Natchpai/proDigialClockE31/Picture1.png

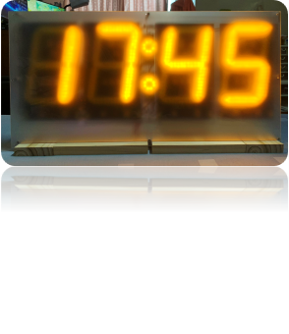
Picture1.png
