Natchpai/proDigialClockE31/Diagrams/Power and control.png

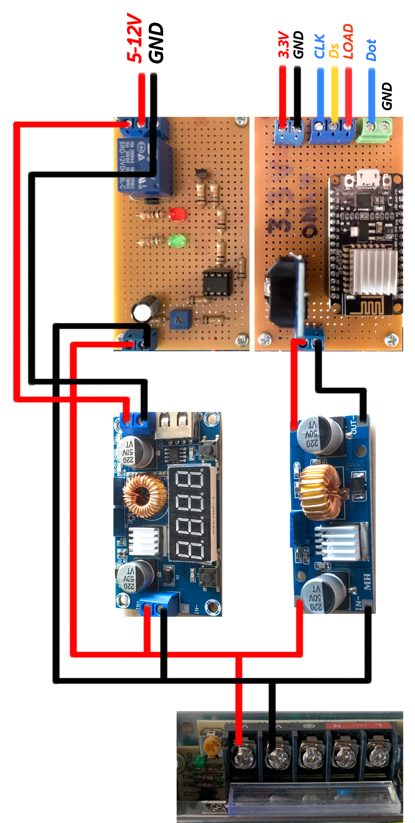
Diagrams/Power and control.png
