Natchpai/proDigialClockE31/README.md

# 4-Digit Digital Clock Class Project
A 4-Digit Digital Clock controlled by ESP8266, Uses custon 7-segment Displays. <br/>
The clock connects to WiFi Automatically to Calibrate its time.



## Features
- Automatic time calibrate via NTP (Network time Protocal)
- Automatic WiFi reconnection
- Room temperature measurement
  
- Size WxH: 60x30cm.
## Last Updated
- **Update 2025: it's working in my room.**
