Natchpai/proDigialClockE31/digitalClockV5.pdf

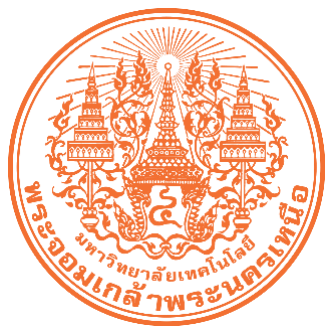
[picture p3: figure]

## รายงาน เรื่อง นาฬิกาดิจิตอล

## จัดทำโดย

## นางสาวกฤติมา พัฒน์ซ้าย

นายธนัท | ตันอึ๊ง
นายณัฐชนน | เถื่อนถ้ำ

## ห้อง E31

## เสนอ

## อาจารย์ปถวีร์ อดิศัยศักดา

## รายงานนี้เป็นส่วนหนึ่งของวิชา Microprocessor Practice ภาคเรียนที่ 2 ปีการศึกษา 2565 โรงเรียนเตรียมวิศวกรรมศาสตร์ ไทย-เยอรมัน

ก

### คำนำ

รายงานฉบับนี้ เป็นส่วนหนึ่งของชิ้นงานในวิชา Microprocessor Practice การจัดทำรายงานและ ชิ้นงานนี้ขึ้นมา มีวัตถุประสงค์เพื่อพัฒนาและต่อยอดนาฬิกาดิจิตอลรุ่นก่อนให้มีประสิทธิภาพมากขึ้น ด้วยรุ่น ก่อนมีปัญหาในเรื่องโครงสร้างการออกแบบที่ซับซ้อน การใช้ไมโครคอนโทรลเลอร์เกินความจำเป็น ความสว่าง ไม่เพียงพอและการสูญเสียพลังงานออกไปในรูปแบบความร้อน โดยรุ่นใหม่นี้ได้ทำการเปลี่ยนโครงสร้างใหม่ ทั้งหมด ซึ่งสามารถปรับระดับความสว่างได้ทำให้การสูญเสียน้อยลง เปลี่ยนวิธีการแสดงผลโดยการใช้ไอซี เลื่อนบิตหรือรีจิสเตอร์แทนที่การแสดงผลด้วยการกระพริบของตัวเลขอย่างรวดเร็ว

แต่รุ่นใหม่นี้ก็ยังมีปัญหาที่เกิดขึ้นอยู่นั้นก็คือ โมดูลนาฬิกา หรือ Real Time Clock Module ในบาง เวลาที่เปิดใช้งานใหม่ๆ ตัว NodeMCU เองไม่สามารถอ่านค่าจากตัวโมดูลนาฬิกาได้จึงจำเป็นต้องถอดตัวโมดูล นาฬิกาออกและใส่เข้าไปใหม่ก็จะใช้งานได้ตามปกติ อันที่จริงแล้วปัญหาที่เกิดขึ้นระหว่างทำชิ้นงานนั้นมีมากเหลือล้น ยกตัวอย่างเช่นการเลือกอุปกรณ์ อย่างทรานซิสเตอร์จะทำอย่างไรให้เกิดความร้อนน้อยที่สุด แต่อย่างไรก็ตามสุดท้ายแล้วก็สามารถทำมันให้ สำเร็จจนได้การจัดทำรายงานและนาฬิกาเรือนนี้ขึ้นมานั้น ผู้พัฒนาหวังว่าจะเป็นประโยชน์ให้กับผู้ที่สนใจ และ ขอขอบคุณที่สละเวลาอันมีค่าของท่านที่อ่านมาถึงตรงนี้ ขอบคุณครับ

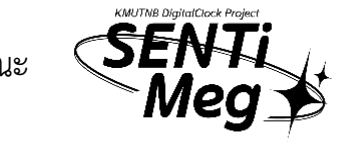
[picture p4: figure]

นายณัฐชนน เถื่อนถ้ำ และคณะ

ข

### สารบัญ

เรื่อง | หน้า
คำนำ | ก
สารบัญ | ข

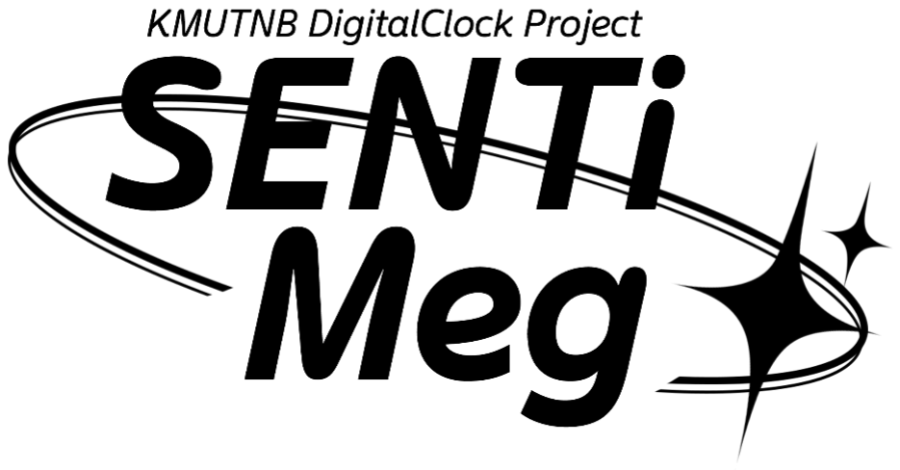
[picture p5: figure]

### ที่มาและความสำคัญ

นาฬิกาดิจิตอลเรือนนี้ได้พัฒนาและต่อยอดมาจากรุ่นก่อนที่มีปัญหาหลายด้าน ด้วยรุ่นก่อนที่มีการ ออกแบบที่ซับซ้อน เสริมนี่นิดเติมนี่หน่อยจนพันกันมั่วไปหมด อีกทั้งปัญหาจากความร้อนที่เกิดขึ้นทำให้เกิด การสูญเสียพลังงานไฟฟ้าโดยไม่ให้เกิดประโยชน์และได้รับหัวข้อมานั้นก็คือการรวมเอาไมโครคอนโทรลเลอร์ สองตัวมารวมกันให้เป็นหนึ่ง โดยรุ่นก่อนจะให้ตัว NodeMCU เป็นตัวดึงข้อมูลเวลาจากอินเตอร์เน็ตแล้วส่งให้ ตัว Arduino กับโมดูลนาฬิกาแสดงผลออกไปที่ 7-Segments ผ่านระบบการกระพริบทีละหลักอย่างรวดเร็ว โดยรุ่นใหม่ที่ได้พัฒนามานี้ได้ทำการเปลี่ยนโครงสร้างใหม่ทั้งหมด โดยเปลี่ยนวิธีการแสดงผล โดยการใช้ไอซี เลื่อนบิตหรือรีจิสเตอร์แทน ซึ่งทำให้มีสายสัญญาณที่น้อยกว่ามาก ลดภาระของตัวไมโครคอนโทรลเลอร์

### คุณสมบัติและสรรพคุณ

นาฬิกาตั้งโต๊ะหรือนาฬิกาแขวนผนัง (ยกเว้น Smart Watch) นั้นมีปัญหาคือต้องตั้งเวลาด้วยตัวเอง หรือก็คือระบบ Manual ซึ่งอาจจะทำให้เวลาคลาดเลื่อนได้จากความเป็นจริงหรืออาจจะเกียจคร้านในการตั้ง พวกเราจึงได้พัฒนาต่อยอดนาฬิกาให้สามารถตั้งเวลาอัตโนมัติเมื่อมีอินเตอร์เน็ตที่สามารถเชื่อมต่อได้สามารถ เชื่อมต่ออินเตอร์เน็ตใหม่ได้เมื่อสัญญาณขาดหายไปชั่วขณะ สามารถปรับความสว่างได้ สามารถตัดระบบเมื่อ แรงดันไฟเกินกำหนดซึ่งเกิดจากการปรับความสว่างที่มากเกิน สามารถแสดงอุณหภูมิห้องได้

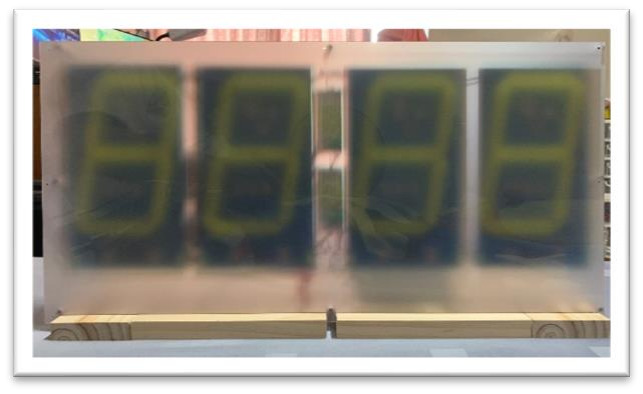
[picture p6: figure]
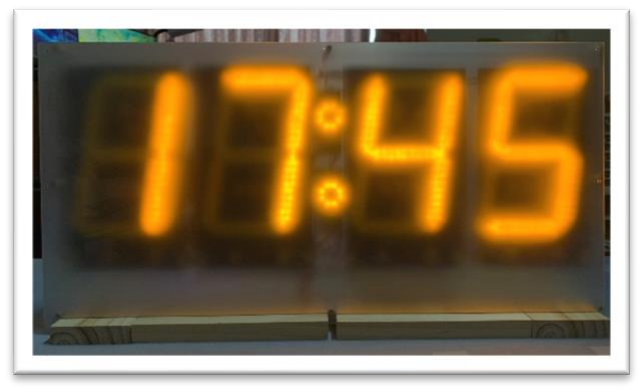
[picture p7: figure]
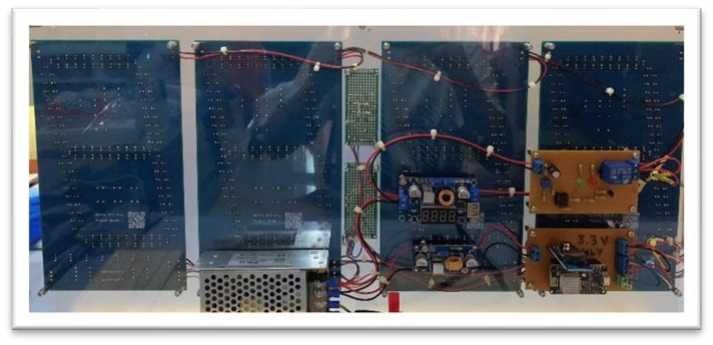
[picture p8: figure]

### วิธีการใช้งาน

### 1. การใช้งาน Buck Converter

Buck Converter หรือ Step down เป็นวงจรอิเล็กทรอนิกส์ที่สามารถทำแรงดันไฟตรงให้ที่เข้ามา ลดลงได้เพื่อให้ค่าแรงดันไฟฟ้ามีความเหมาะสมสำหรับการนำไปใช้ในงานอื่นๆ โดยที่นาฬิกาดิจิตอลเรือน นี้ได้นำวงจรนี้มาใช้ด้วยกัน 2 ตัวคือ
1. Buck Converter (Main)
2. Buck Converter (Sub)
1.1Buck Converter (Main)

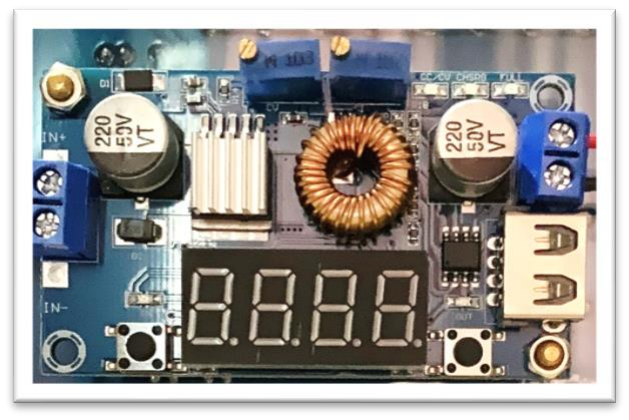
[picture p9: figure]

### 1.1.1 การปรับและควบคุมแรงดันไฟฟ้ากระแสตรง

วงจร Step down วงจรนี้ทำหน้าที่จ่ายกำลังหลักให้กับหน้าจอแสดงผลโดย สามารถปรับแรงดันได้โดยการปรับทริมพอร์ตด้านซ้ายมือสุด โดยจะมีสัญลักษณ์ CV หรือ (Control Voltage) กำกับที่ตัวทริมพอร์ต ส่วนทริมพอร์ตด้านขวาสุดจะเป็นการปรับ กระแสสูงสุด โดยจะมีสัญลักษณ์ CC หรือ (Control Current) กำกับที่ตัวทริมพอร์ตอยู่

### 1.1.2 การตั้งค่าหน้าจอแสดงผล

วงจร Step down วงจรนี้มีหน้าจอแสดงผลอยู่และมีปุ่มข้างซ้ายและขวาของ จอแสดงผล ปุ่มซ้ายเป็นการปิดหน้าจอแสดงผล ส่วนปุ่มขวาจะเป็นการเลือกโหมด การแสดงผลโดยจะมีอยู่ 4 โหมดดังนี้คือ 1. แรงดันอินพุต 2. แรงดันเอาต์พุต 3. กระแสเอาต์พุต 4. กำลังเอาต์พุต หรือจะดูที่สัญลักษณ์ V (Volt) A (Amp) และ P (Power) ก็ได้ โดยจะมีไฟแสดงสถานะเป็นสีแดงด้านบนปุ่มกดทั้งสอง ถ้าสว่าง ทางด้านปุ่มซ้ายมือหมายถึงแสดงผลทางด้านอินพุต ถ้าสว่างทางขวามือหมายถึง แสดงผลทางเอาต์พุต

### วิธีการใช้งาน (ต่อ)

### 1.2 Buck Converter (Sub)

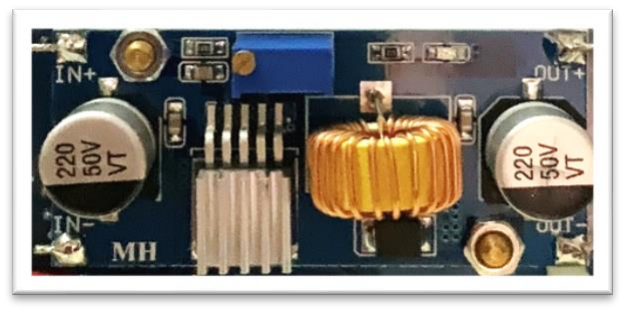
[picture p10: figure]

### 1.2.1 การปรับและควบคุมแรงดันไฟฟ้ากระแสตรง

วงจร Step down วงจรนี้ทำหน้าที่จ่ายกำลังให้กับตัวไมโครคอนโทรลเลอร์และ ไอซีควบคุมต่างๆในซึ่งเป็นส่วนหนึ่งของวงจรแสดงผลโดยสามารถปรับแรงดันได้โดยการ ปรับทริมพอร์ตสีน้ำเงินตรงกลาง โดยจะไม่แนะนำให้ทำการปรับแรงดันไฟฟ้าในวงจรนี้ เพราะตัวไมโครคอนโทรลเลอร์เองอาจได้รับความเสียหายได้โดยวงจรนี้จะทำการคงที่ แรงดันไว้ประมาณ 3.28 Volt

### 2. การเชื่อมต่อกับอินเตอร์เน็ต

กระจายไวไฟผ่านมือถือหรือจะเป็นเร้าเตอร์ที่สามารถเข้าถึงอินเตอร์เน็ตได้ ตัว NodeMCU สามารถ เชื่อมต่อสัญญาณใหม่ได้ตลอดเวลาโดยไม่ต้องกดปุ่มใดๆ แต่จำเป็นต้องตั้งค่าชื่อและรหัสผ่านของไวไฟที่ ต้องการให้เชื่อมต่อด้วย (จะกล่าวถึงในส่วนถัดๆไป)

### 3. การปรับความสว่างการแสดงผล

การปรับความสว่างการแสดงผลสามารถปรับได้โดยการเพิ่มหรือลดแรงดันไฟตรงที่จ่ายให้กับหน้าจอ แสดงผลหลัก โดยการปรับทริมพอร์ตด้านซ้ายมือสุดที่วงจร Buck Converter (Main) โดยจะมีสัญลักษณ์ CV หรือ (Control Voltage) กำกับที่ตัวทริมพอร์ตเอง (สามารถดูเพิ่มเติมได้จากหน้าที่ 2 หัวข้อการปรับ และควบคุมแรงดันไฟฟ้ากระแสตรง)

### 3.1 การกำหนดความสว่างสูงสุดให้กับหน้าจอแสดงผล

การกำหนดความสว่างหรือแรงดันสูงสุดให้กับหน้าจอแสดงผลเพื่อป้องกันการเกิดอัคคีภัยที่ อาจเกิดขึ้นได้จากความร้อนได้ที่ตัววงจรสร้างขึ้นเพราะมีแรงดันอินพุตที่สูงเกินไปจากการปรับ ความสว่างหน้าจอของตัวคุณเอง (วิธีการตั้งค่าอยู่หน้าถัดไป)

### วิธีการใช้งาน (ต่อ)

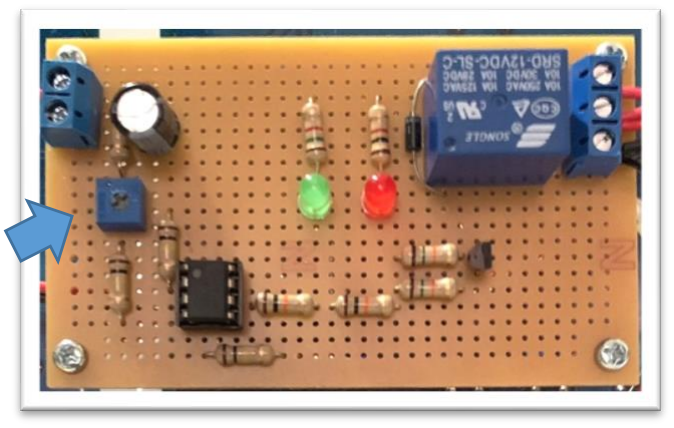
[picture p11: figure]

วิธีการตั้งค่าแรงดันสูงสุดมี 3 ขั้นตอน คือ

1. ปรับแรงดันสูงสุดตามที่ต้องการที่ตัว Buck Converter (Main) โดยดูทางด้านแรงดันเอาต์พุต
2. ปรับทริมพอร์ตสีน้ำเงินทางซ้ายมือที่อยู่ในบอร์ดในภาพด้านบนจนกว่าไฟสถานะสีแดงจะสว่างขึ้น หรือถ้าสว่างอยู่แล้วให้ปรับจนกว่าจะไฟจะดับลงแล้วค่อยๆปรับขึ้นใหม่จนไฟสถานะติดอีกครั้ง
3. ลดแรงดันเอาต์พุตที่ตัว Buck Converter (Main) ที่ตั้งไว้ตอนแรก ให้อยู่ในสถานะปกติ เมื่อวงจรอยู่ในสถานะปกติจะมีไฟสถานะสีเขียวติดอยู่แสดงว่าวงจรสามารถทำงานได้ส่วนไฟสถานะสี แดงหมายถึงการตัดการจ่ายไฟหลักให้กับวงจรแสดงผล

### 4. การตั้งค่าการเชื่อมต่ออินเตอร์เน็ตและอื่นๆ

การตั้งค่าการเชื่อมต่ออินเตอร์เน็ตหรือการเปลี่ยนชื่อและรหัสไวไฟหรือการตั้งค่าต่างๆนั้นจำเป็นอย่าง มากที่จะต้องอัปโหลดโปรแกรมใหม่ให้กับตัวไมโครคอนโทรลเลอร์มีวิธีดังนี้
1. สแกน QR CODE ด้านหลังแผงวงจร หรือเข้าลิงก์ https://github.com/Natchpai/proDigialClockE31 (ไม่ใช่ proDigitalClockE31)
2. ไปที่โฟลเดอร์ชื่อ CODE / FINAL_CODE_ClockProject ตามรูปด้านล่าง (แต่ถ้าสแกน QR CODE ให้ไปที่โฟลเดอร์ชื่อ DigitalClockProject ก่อน)

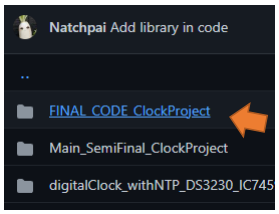
[picture p12: figure]
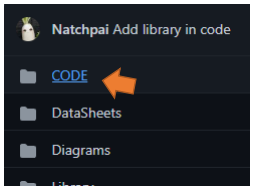
[picture p13: figure]

### วิธีการใช้งาน (ต่อ)

3. FINAL_CODE_ClockProject.ion เป็นโค้ดที่จำเป็นต้องลง Library บางตัว สามารถดู เพิ่มเติมได้ในโค้ด ส่วนในโฟลเดอร์นี้จะมีมาให้ 2 ตัว สามารถลงได้เลย

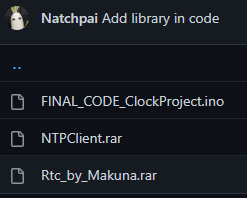
[picture p14: figure]

4. สามารถเปลี่ยน SSID และ password แล้วอัปโหลดใหม่ได้เลย ส่วน pullData_hour คือการตั้งเวลาทุกๆกี่ชั่วโมง เมื่อมีการเชื่อมต่ออินเตอร์เน็ต ในที่นี้คือ ทุกๆ 6 ชม.

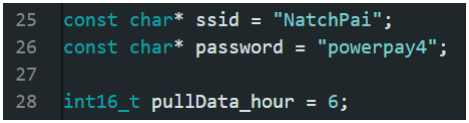
[picture p15: figure]

5. สามารถเปลี่ยนเวลาการเปลี่ยนโหมดระหว่างแสดงเวลากับอุณหภูมิได้ ในเงื่อนไข mode == 1 คือแสดงเวลา ส่วน mode == 2 คือแสดงอุณหภูมิ

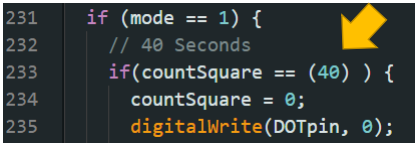
[picture p16: figure]
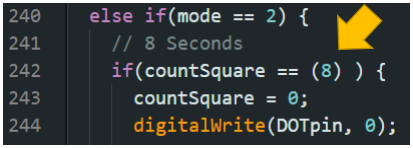
[picture p17: figure]

### ข้อควรระวัง

1. ไม่แนะนำให้ปรับแรงดันที่วงจร Buck Converter (Sub) เพราะอาจจะทำให้ไมโครคอนโทรลเลอร์ เสียหายได้ ซึ่งวงจรนี้จะคงแรงดันไว้ที่ 3.28 Volt โดยประมาณ
2. ไม่แนะนำให้ปรับ CC หรือ Control Current ที่วงจร Buck Converter (Main)
3. ไม่แนะนำให้ตั้ง CC หรือ CV ที่วงจร Buck Converter (Main) ผ่านการกดปุ่ม
4. อย่าปรับความสว่างหรือแรงดันมากจนเกินเพราะอาจเกิดอัคคีภัยได้
5. ระวังแผ่นอะคริลิกแตก

### ปัญหาที่อาจเกิดขึ้นได้

ปัญหาโมดูลนาฬิกา หรือ Real Time Clock Module ในบางเวลาที่เปิดใช้งานใหม่ๆ ตัว NodeMCU เองไม่สามารถอ่านค่าจากตัวโมดูลนาฬิกาได้ทำให้เกิดการแสดงเวลาที่ผิดเป็นเวลา 00:00 และ 00°C มีวิธีแก้ด้วยกัน 2 วิธีคือ

1. ถอดปลั๊กนาฬิกาออกจากเต้าแล้วเสียบเข้าไปใหม่อีกทีหรือ
2. ดึงโมดูลนาฬิกาออกและใส่เข้าไปใหม่ขณะที่นาฬิกากำลังทำงานอยู่ (ใส่ให้ถูกด้านด้วย)

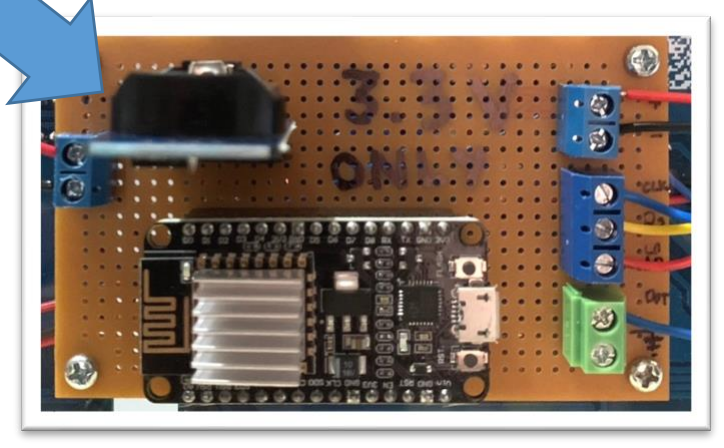
[picture p18: figure]

### ส่วนประกอบของชิ้นงาน

### 1. โดยภาพรวม

1. หน้าจอแสดงผล 7-Segments x 4 แผ่น | 5. Buck Converter ขนาด 2 แอมป์

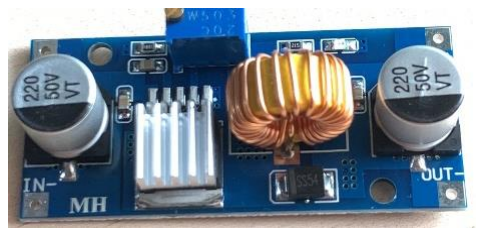
[picture p19: figure]

6. NodeMCU ESP8266 V2

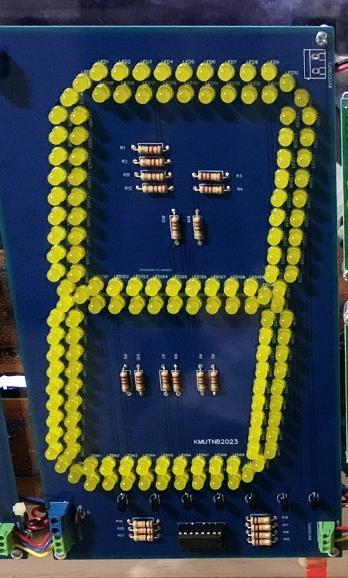
[picture p20: figure]
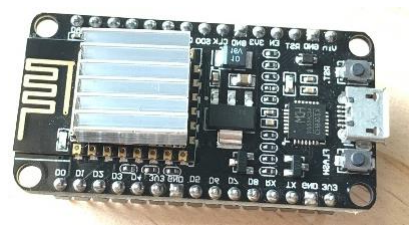
[picture p21: figure]
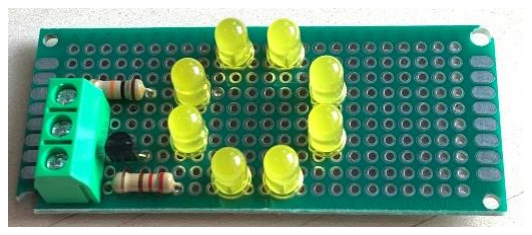
[picture p22: figure]
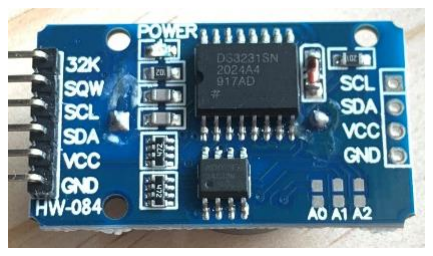
[picture p23: figure]

2. หน้าจอแสดงผลแบบ Dot x 2 แผ่น | 7. DS3231 (RTC Module)

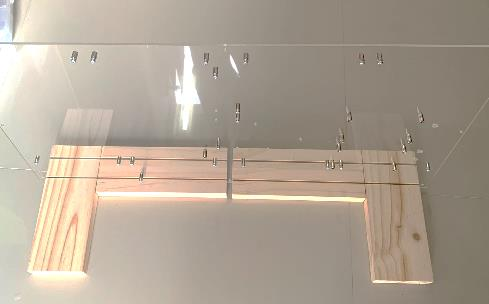
[picture p24: figure]
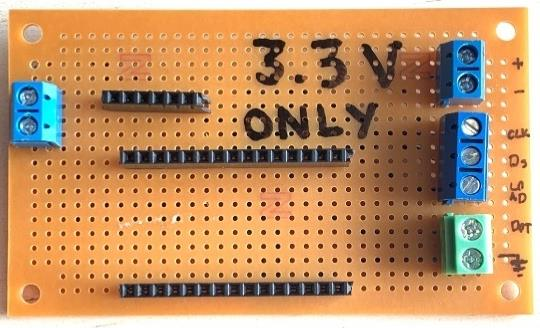
[picture p25: figure]

3. ฐานไม้ แผ่นอะคริลิกใส และแผ่นอะคริลิกขุ่น | 8. ฐานใส่ NodeMCU, RTC Module

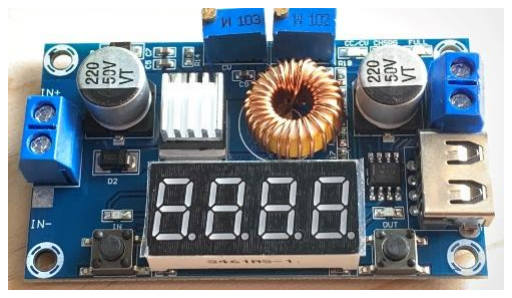
[picture p26: figure]
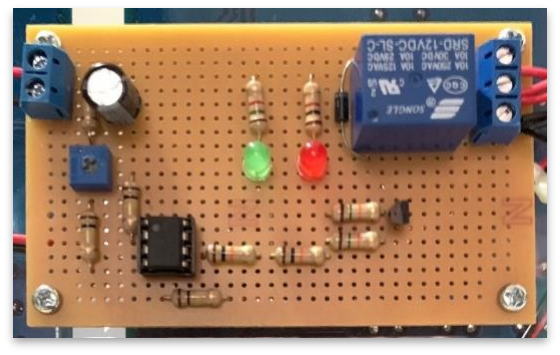
[picture p27: figure]

4. Buck Converter ขนาด 5 แอมป์ | 9. วงจรตัดแรงดันไฟเกินกำหนด

### ส่วนประกอบของชิ้นงาน (ต่อ)

10. Power Supply ขนาด 220VAC แปลงเป็น 12VDC-5A.

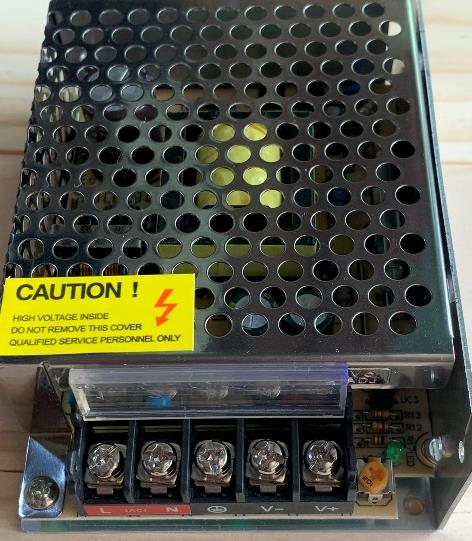
[picture p28: figure]

ภาพรวมด้านหน้า

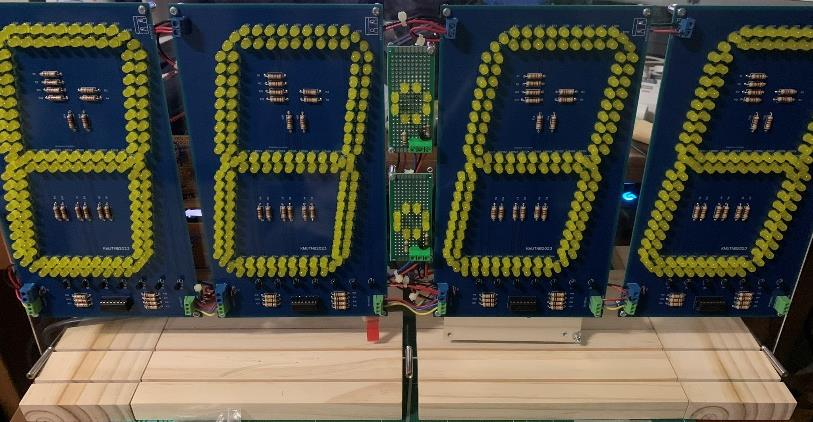
[picture p29: figure]

ภาพรวมด้านหลัง

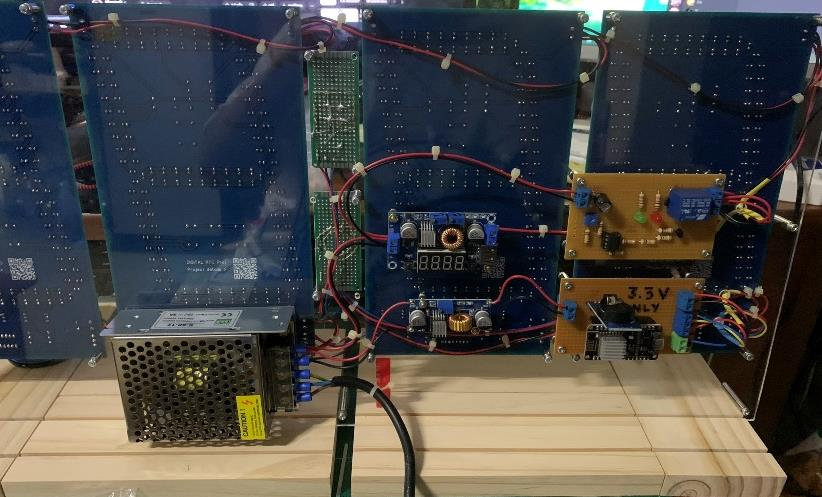
[picture p30: figure]

### ส่วนประกอบของชิ้นงาน (ต่อ)

### 2. อุปกรณ์ในหน้าจอแสดงผล 7-Segments

1. แผ่น PCB x 1 แผ่น
2. หลอด LED สีเหลืองขนาด 5mm. x 140 ดวง
3. ตัวต้านทาน 220 Ω x 14 ตัว
4. ตัวต้านทานขนาด 10 KΩ x 7 ตัว
5. ทรานซิสเตอร์เบอร์ 2N3904 x 7 ตัว
6. ไอซีเบอร์ 74HC595 พร้อม Socket 16 pin x 1 ตัว
7. ตัวเก็บประจุชนิดเซรามิก 0.1µF x 1 ตัว
8. Screw Terminal ขนาด 5mm. 2 pin x 2 ตัว
9. Screw Terminal ขนาด 3.5mm. 3 pin x 2 ตัว

### 3. อุปกรณ์ในวงจรตัดแรงดันไฟเกินกำหนด

1. รีเลย์ไฟตรงขนาด 12 โวลต์ เบอร์ SRD-12VDC-SL-C x 1 ตัว
2. ไดโอดเบอร์ 1N4001 x 1 ตัว
3. หลอด LED 5mm. สีแดงและสีเขียว อย่างละ 1 ดวง
4. ตัวต้านทานขนาด 15 KΩ x 2 ตัว
5. ตัวต้านทานขนาด 10 KΩ x 2 ตัว
6. ตัวต้านทานขนาด 100 KΩ x 4 ตัว
7. ตัวต้านทานขนาด 1 KΩ x 1 ตัว
8. ตัวต้านทานขนาด 1.5 KΩ x 1 ตัว
9. ทริมพอร์ต 1 รอบ ขนาด 50 KΩ x 1 ตัว
10. ไอซีเบอร์ LM741 พร้อม Socket 8 pin x 1 ตัว
11. ทรานซิสเตอร์เบอร์ 2N3904 x 1 ตัว
12. ตัวเก็บประจุชนิดอิเล็กโทรไลต์ขนาด 100µF 50V x 1 ตัว
13. Screw Terminal ขนาด 5mm. 2 pin x 1 ตัว
14. Screw Terminal ขนาด 5mm. 3 pin x 1 ตัว
15. แผ่นวงจรสำเร็จ IC3 x 1 แผ่น

### วงจรของชิ้นงาน

1. (Diagram) ส่วนการ Control และ Power

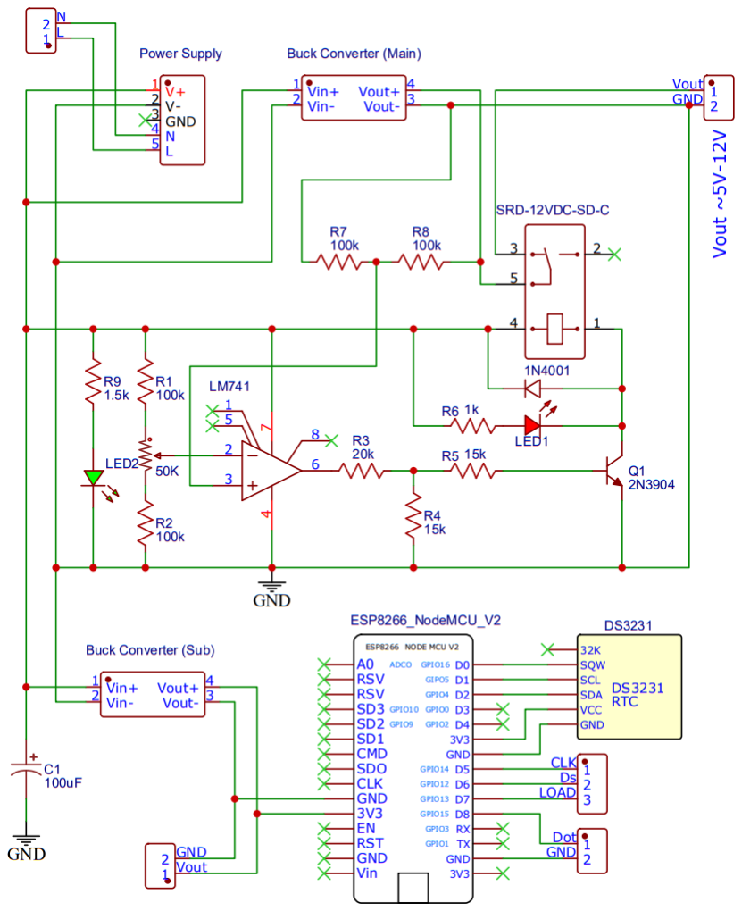
[picture p31: figure]

### วงจรของชิ้นงาน (ต่อ)

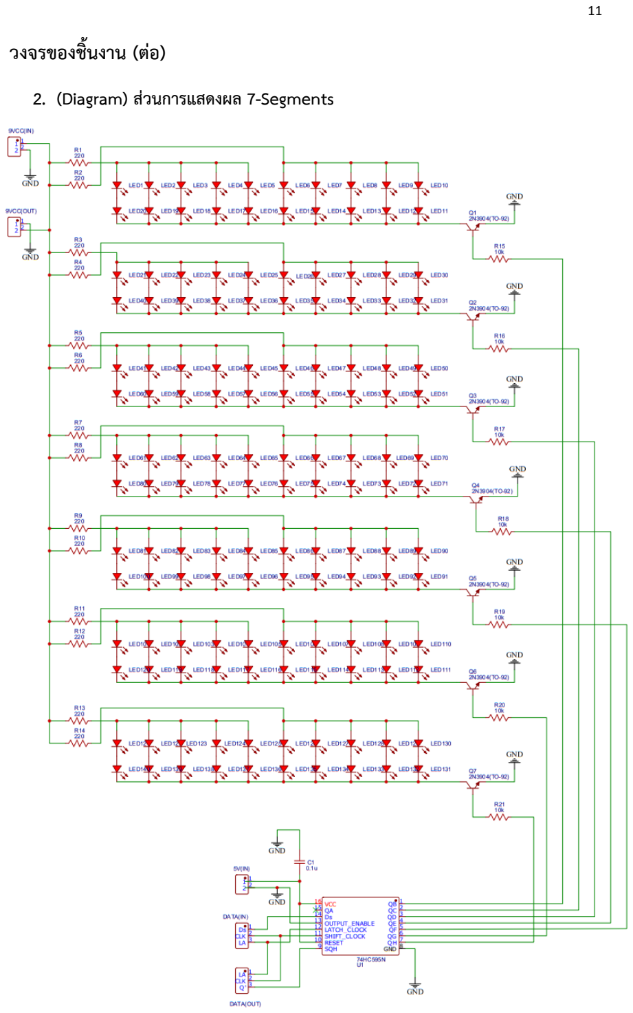
[picture p32: page 16]

2. (Diagram) ส่วนการแสดงผล 7-Segments

### วงจรของชิ้นงาน (ต่อ)

3. (การต่อจริง) ส่วนการ Control และ Power

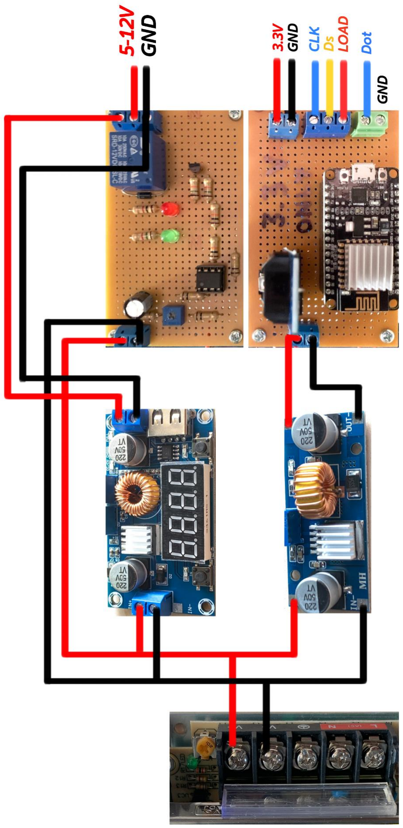
[picture p33: figure]

### วงจรของชิ้นงาน (ต่อ)

4. (การต่อจริง) ส่วนการแสดงผล 7-Segments

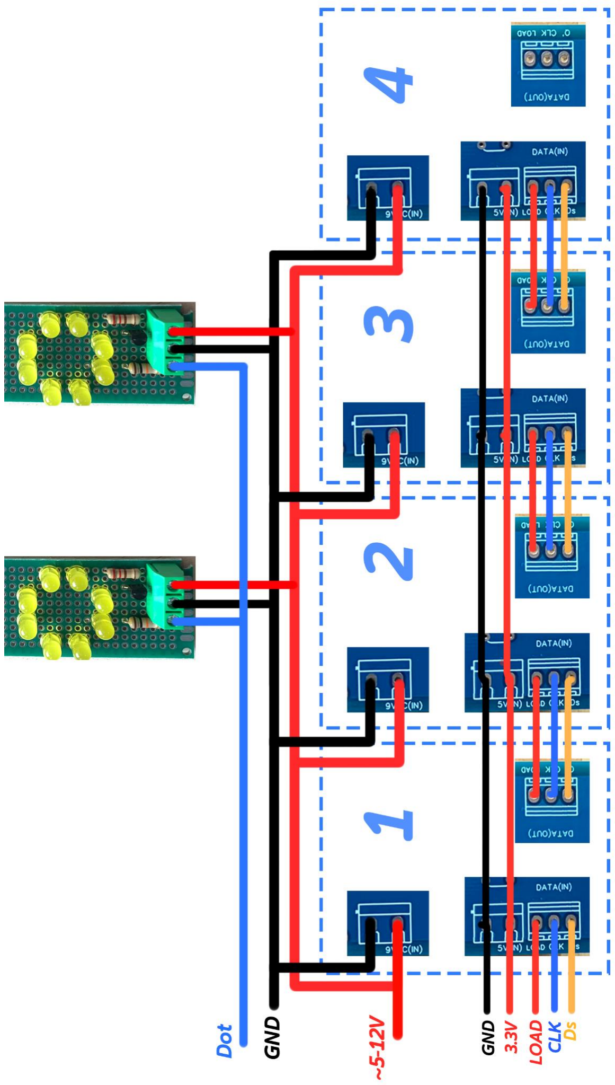
[picture p34: figure]

### เกี่ยวกับ 74HC595

ไอซี74HC595 เป็นไอซีเลื่อนบิต เมื่อมีการป้อนข้อมูลเข้าไปใหม่ บิตจะถูกเลื่อนไปตามข้อมูลที่ป้อน มี ขาทั้งหมด 16 ขา เป็นขาเอาต์พุตที่ควบคุมได้ทั้งหมด 8 ขา ตั้งแต่ Q0 Q1 Q2 ... Q7 มีขา 3 ขาสำหรับการ ควบคุมขา Q0 - Q7 ไอซีชนิดนี้จะมาช่วยในเรื่องการขยายขาส่งข้อมูลดิจิตอลให้มากขึ้น

1. ขา ST_CP หรือเทียบได้กับการ Latch เป็นขาควบคุมจังหวะการส่งข้อมูลออก เมื่อขานี้มีสถานะ เป็น HIGH จะมีการโหลดข้อมูลออกไปที่ขา Q0 Q1 Q2 ... Q7 ตามข้อมูลที่ส่งเข้ามา
2. ขา SH_CP เทียบได้กับขา Clock เป็นขาที่จะต้องป้อนสัญญาณพัลส์เข้าไปเพื่อควบคุมการรับ ข้อมูลเข้าไอซีโดยการป้อนสัญญาณจะต้องสัมพันธ์กับการป้อนข้อมูลในแต่ละบิต
3. ขา DS เป็นขาสำหรับป้อนข้อมูลเข้าไปทีละบิตตามจังหวะสัญญาณนาฬิกา
4. ขา Q7S หรือ QH’ เป็นขาข้อมูลออก สามารถนำไปต่อกับขา DS ของตัวถัดๆไปเพื่อขยาย ความสามารถในการส่งข้อมูลได้
5. ขา MR หรือขา Reset ทำงานในสถานะ LOW
6. ขา OE หรือ Output Enable Input ทำงานในสถานะ LOW

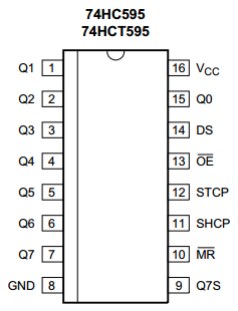
[picture p35: figure]
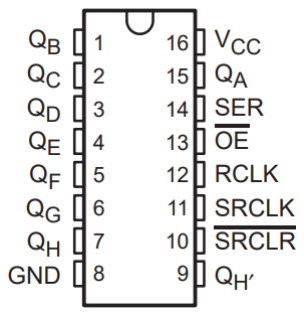
[picture p36: figure]

### เกี่ยวกับ 74HC595

การใช้งานไอซีเลื่อนบิต 74HC595 ด้วย shiftOut()
ฟังก์ชัน shiftOut เป็นฟังก์ชันส่งข้อมูลแบบซิงโครนัส โดยสามารถกำหนดขา data และ clock เข้าไปใส่ในฟังก์ชันได้โดยในที่นี้74HC595 นั้นสามารถรับข้อมูลได้มากสุด 8 บิตต่อหนึ่งตัว แต่ สามารถนำไอซีแต่ละตัวมาต่ออนุกรมกันเพื่อขยายความสามารถในการเก็บข้อมูลให้มากขึ้นได้ shiftOut(dataPin, clockPin, bitOrder, value);

dataPin คือ ขาที่ต่อใช้งานกับขา Ds ของ 74HC595
clockPin คือ ขาที่ต่อใช้งานกับขา SH_CP ของ 74HC595
bitOrder คือ การตั้งค่าการเรียงลำดับของข้อมูลที่จะส่งออกว่าจะส่งบิตความสำคัญสูงหรือ บิตความสำคัญต่ำออกก่อน MSBFIRST or LSBFIRST
value คือข้อมูลจำนวน 8 บิตที่จะส่งออก สามารถใช้ค่าจากตัวแปร byte หรือ uint8_t
1. ตัวอย่างการใช้งานฟังก์ชัน shiftOut กับ 74HC595 แบบ 8 บิต

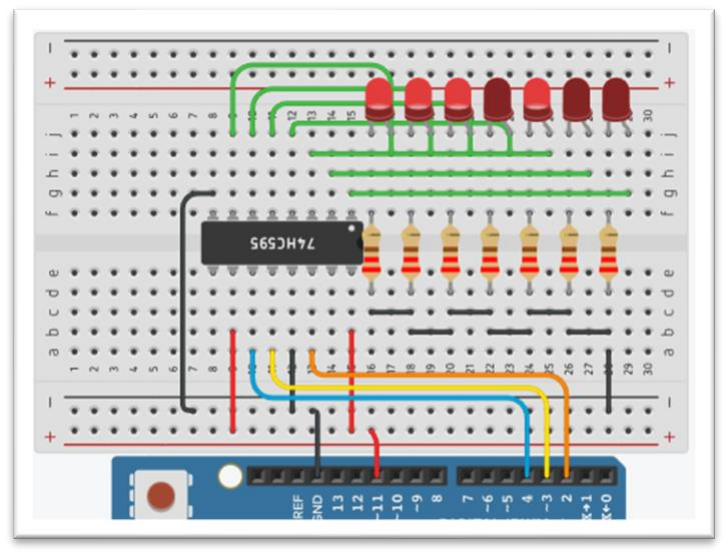
[picture p37: figure]
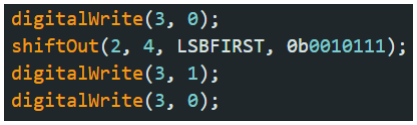
[picture p38: figure]

### เกี่ยวกับ 74HC595

การใช้งานไอซีเลื่อนบิต 74HC595 ด้วย shiftOut() (ต่อ)

2. ตัวอย่างการใช้งานฟังก์ชัน shiftOut กับ 74HC595 แบบ 16 บิต โดยการเพิ่มไอซีนั้นจำเป็นต้องนำขาที่ 9 หรือขาข้อมูลออกไปต่อกับขา 16 หรือขาข้อมูล เข้าของไอซีอีกตัว (สีเขียว) และต่อขนานสัญญาณนาฬิกา (สีฟ้า) และสัญญาณโหลดข้อมูล (สี เหลือง) ด้วยถึงจะสามารถทำงานได้

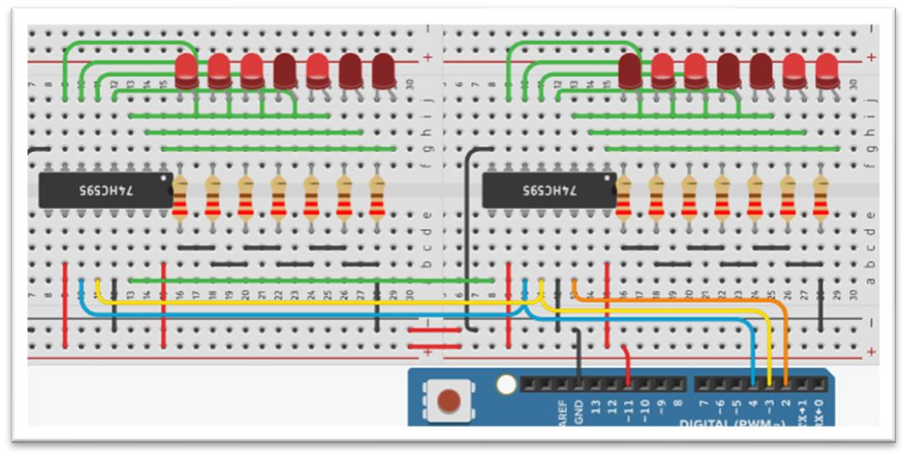
[picture p39: figure]
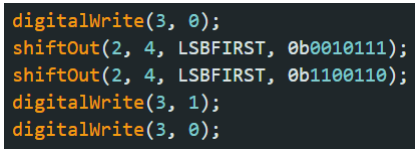
[picture p40: figure]

### โค้ดโปรแกรม

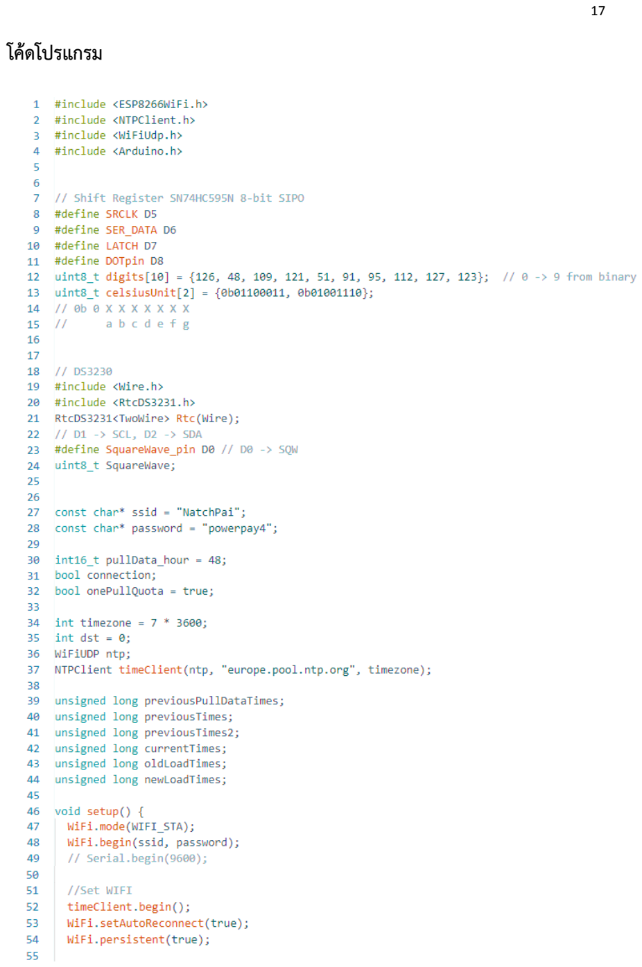
[picture p41: page 22]

### โค้ดโปรแกรม

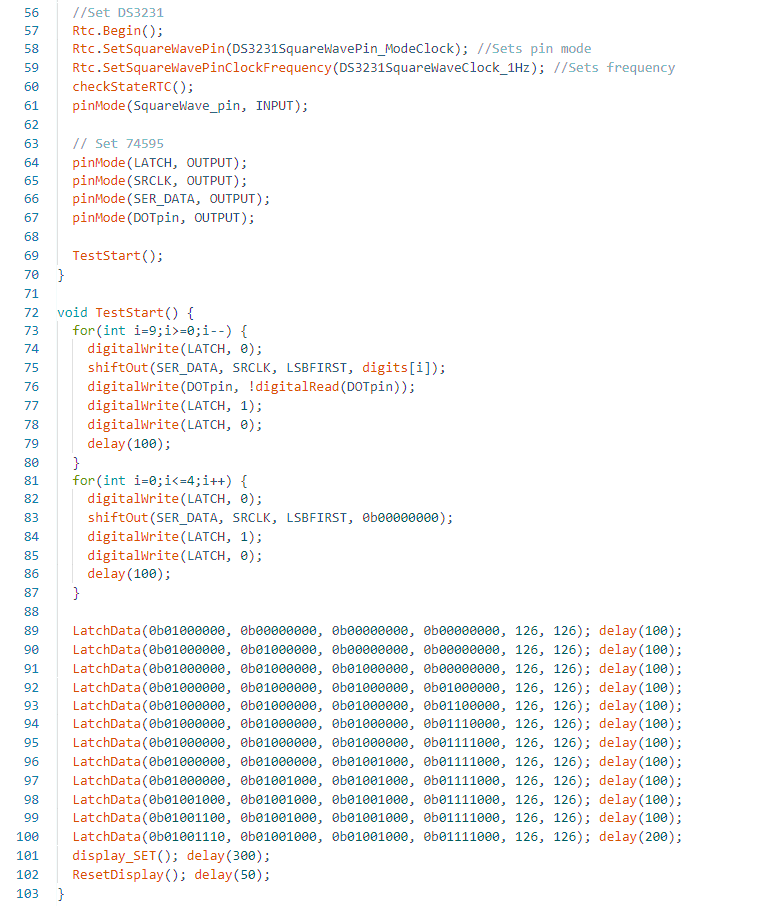
[picture p42: figure]

### โค้ดโปรแกรม

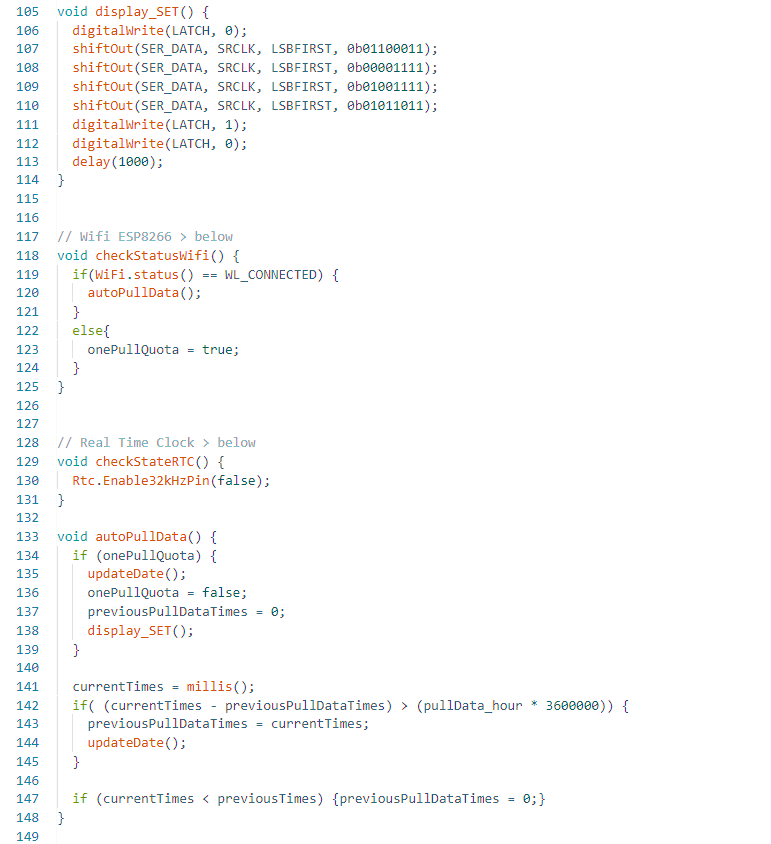
[picture p43: figure]

### โค้ดโปรแกรม

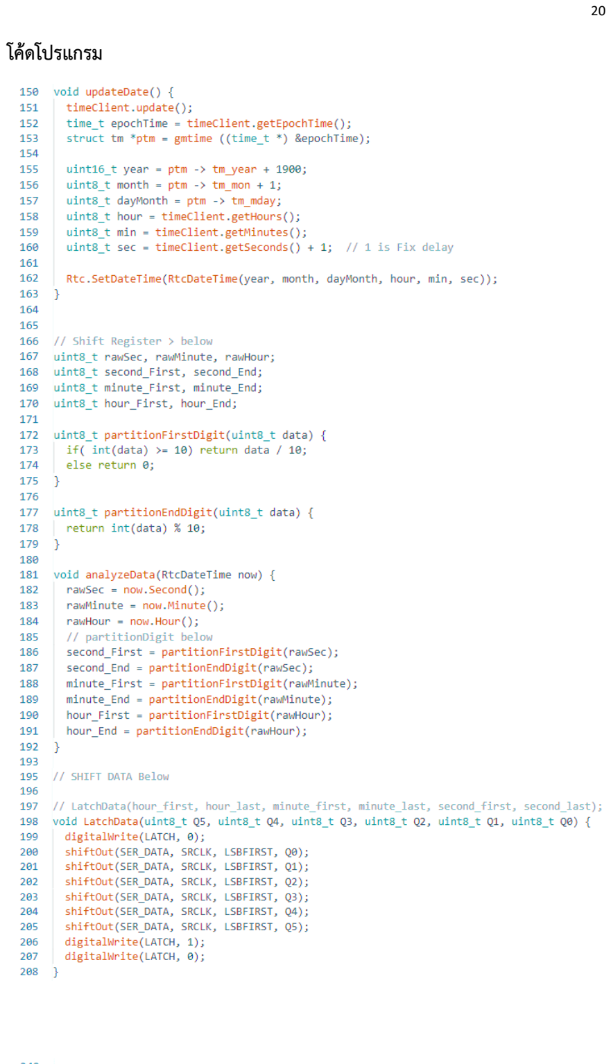
[picture p44: page 25]

### โค้ดโปรแกรม

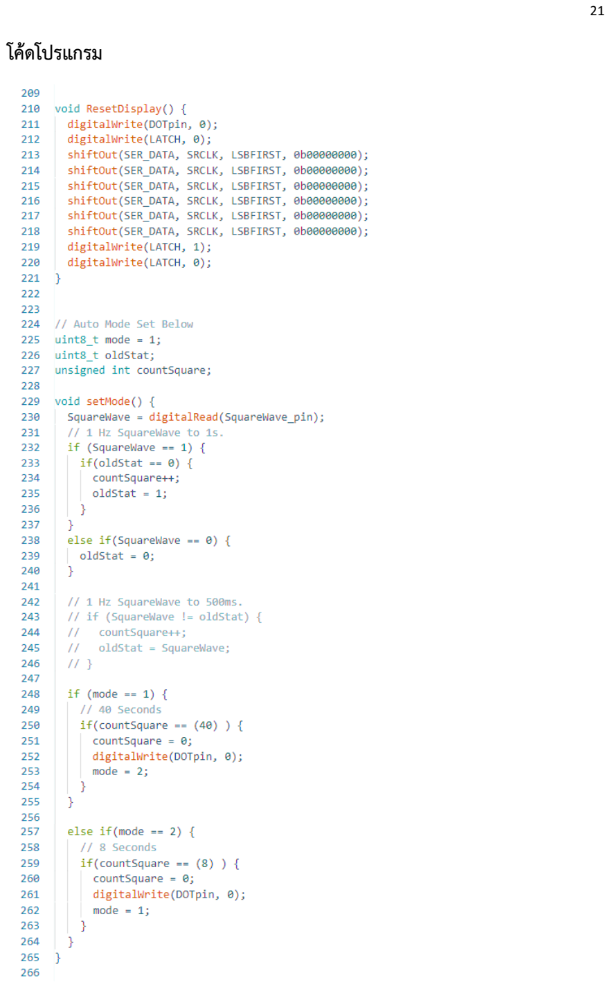
[picture p45: page 26]

### โค้ดโปรแกรม

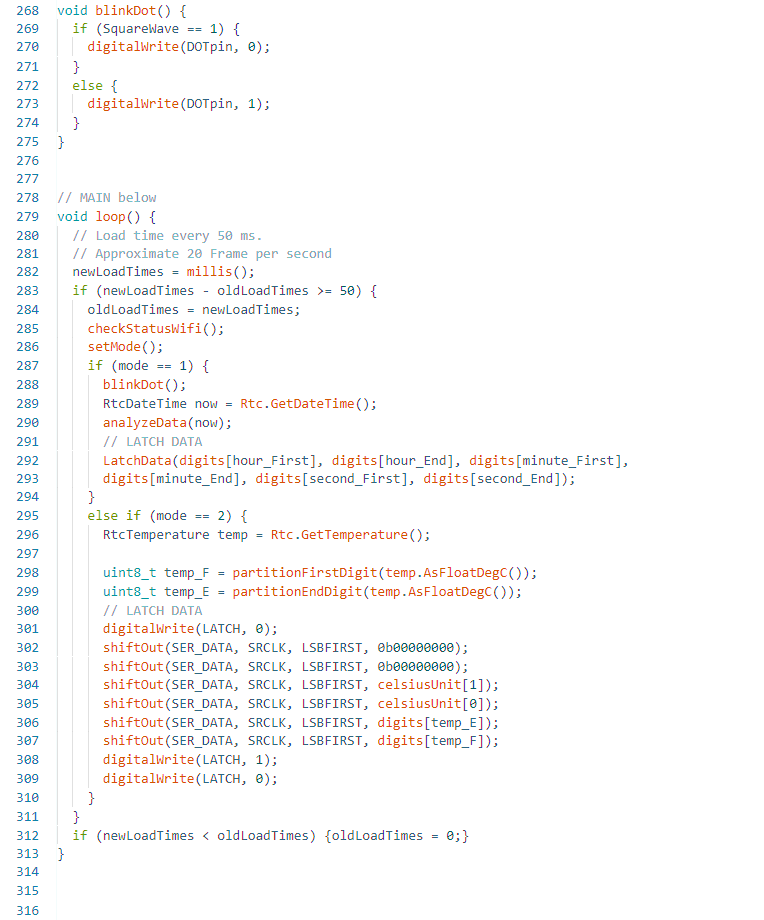
[picture p46: figure]
