Natchpai/proDigialClockE31/Diagrams/display.png

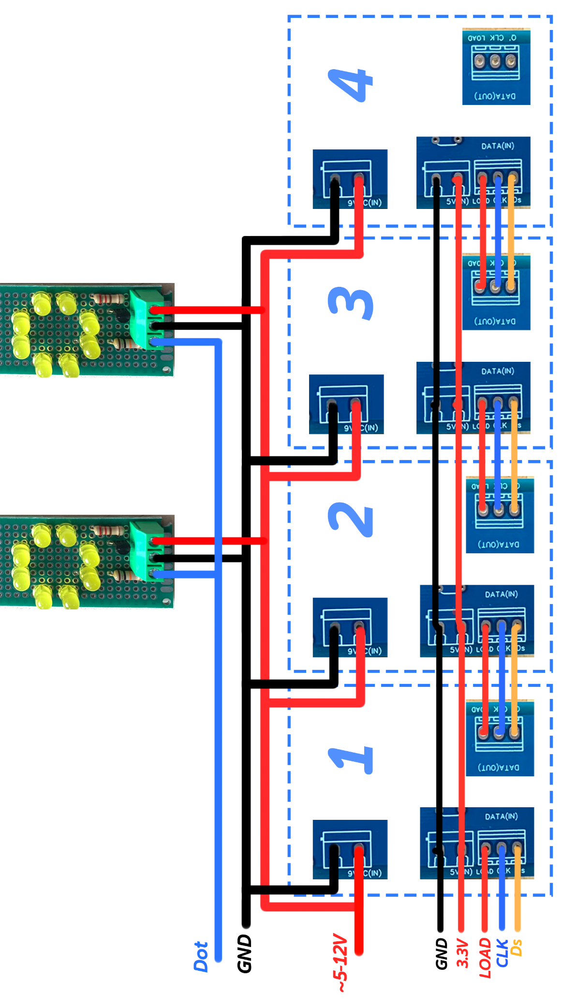
Diagrams/display.png
