Natchpai/proDigialClockE31/Diagrams/Schematic_7Segment.png

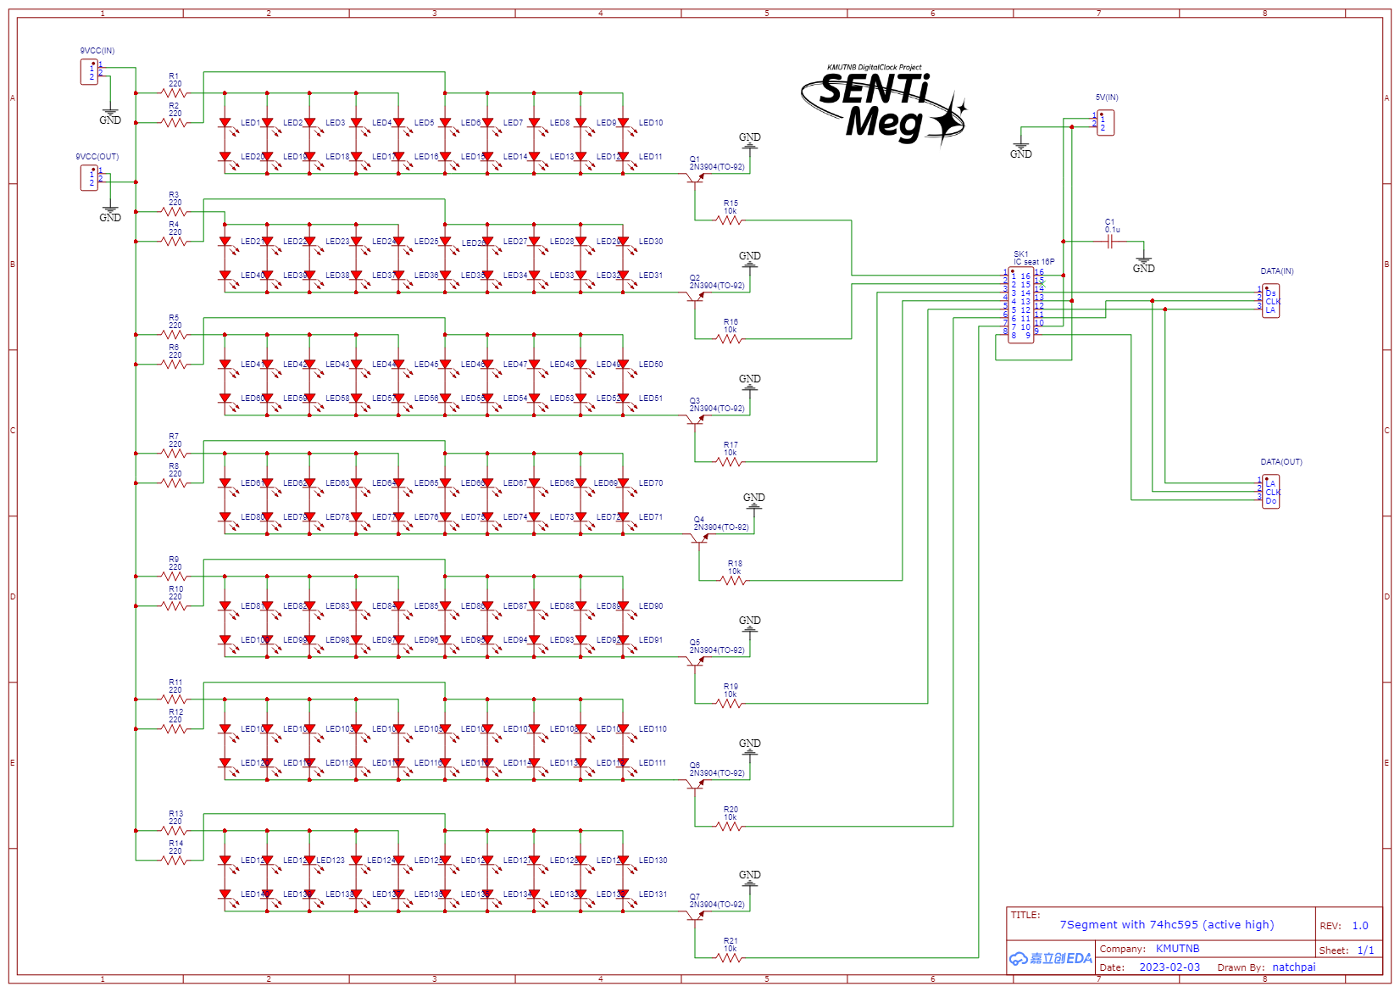
Diagrams/Schematic_7Segment.png
