Natchpai/proDigialClockE31/Reference/8x8x8 club LED SchematicDiagram.png

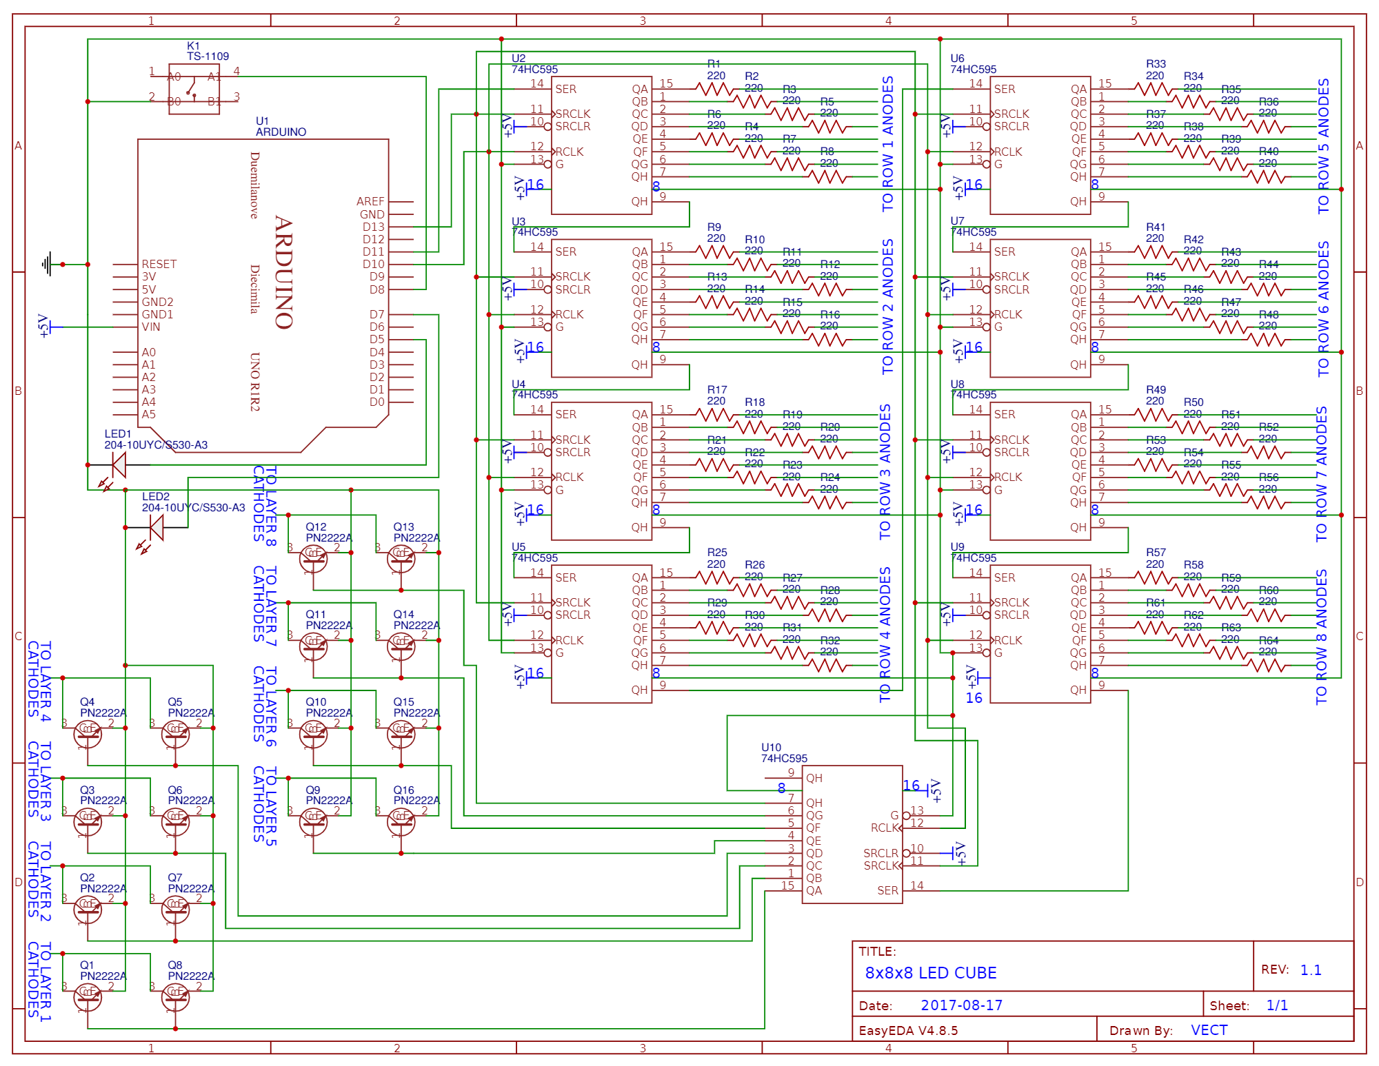
Reference/8x8x8 club LED SchematicDiagram.png
