Natchpai/proDigialClockE31/Reference/74HC595-Shift-Register-Working.gif

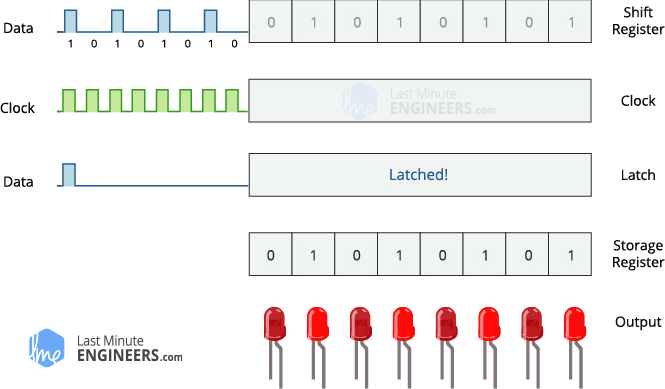
Reference/74HC595-Shift-Register-Working.gif
