Natchpai/proDigialClockE31/Reference/100 LED chaser.jpg

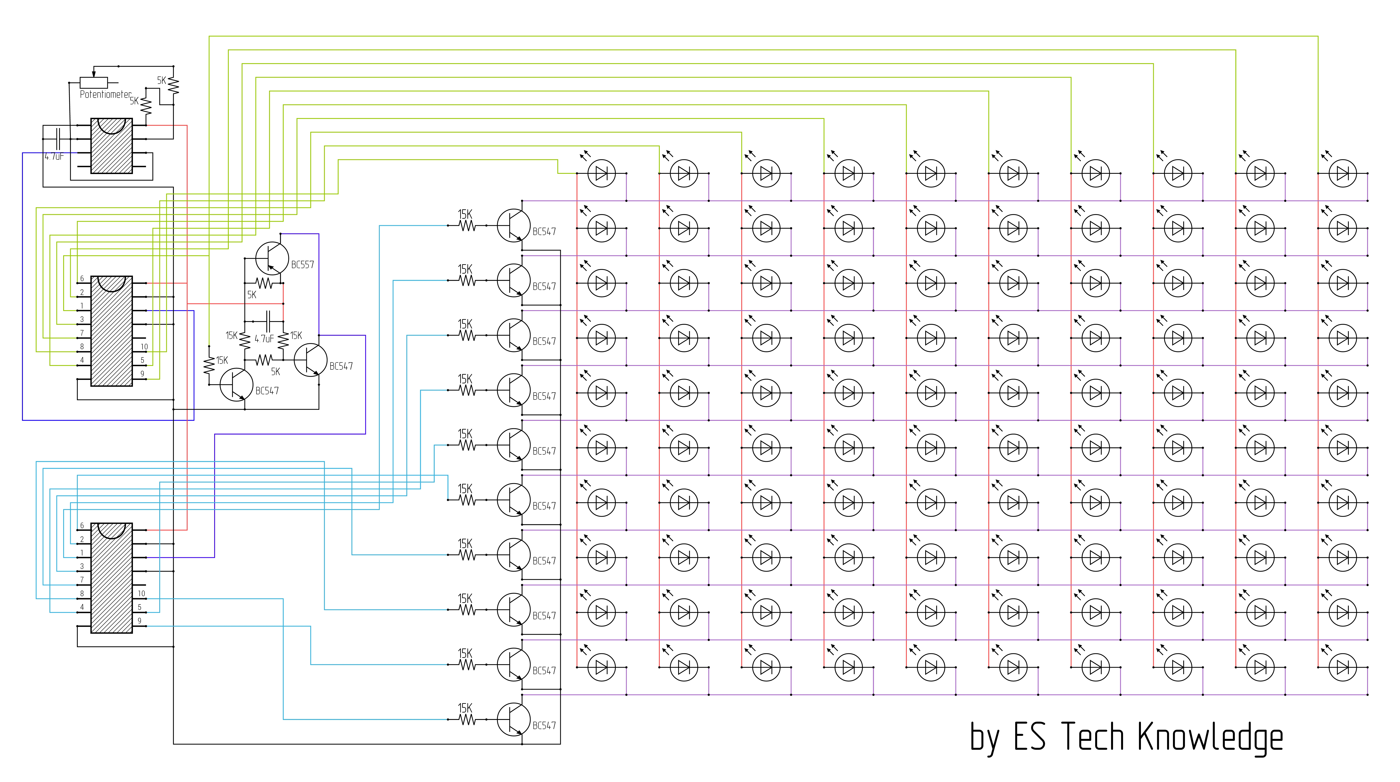
Reference/100 LED chaser.jpg
