Natchpai/proDigialClockE31/Reference/Arduino real time six digit clock SchematicDia.jpg

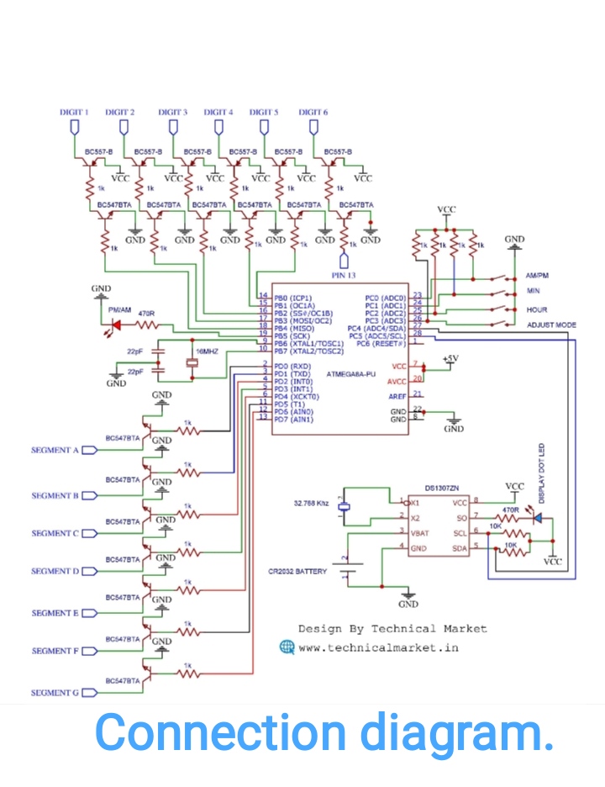
Reference/Arduino real time six digit clock SchematicDia.jpg
