Natchpai/proDigialClockE31/SENTiMeg2.png

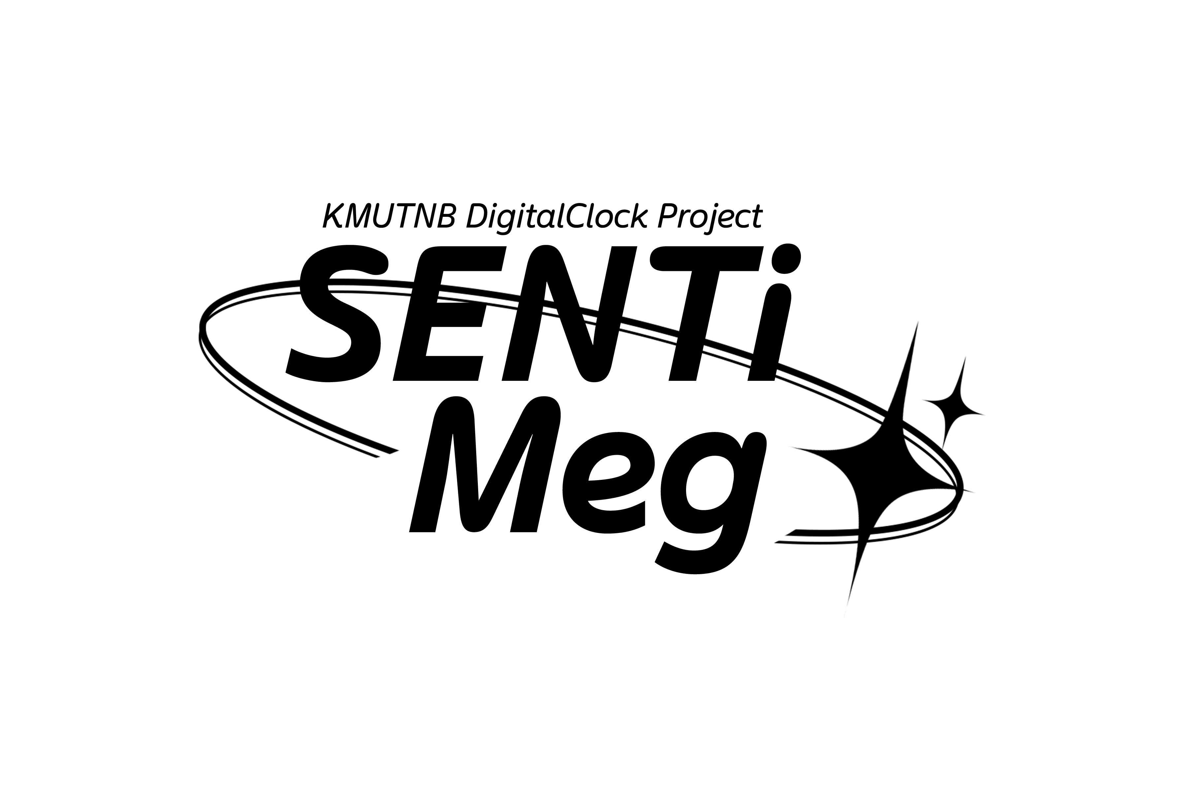
SENTiMeg2.png
