Natchpai/proDigialClockE31/DigitalClockPresentV3.pdf

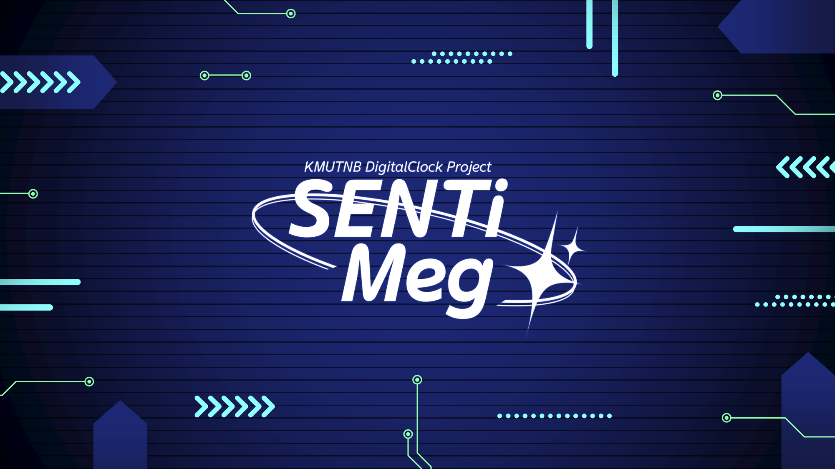
[picture p54: page 1]

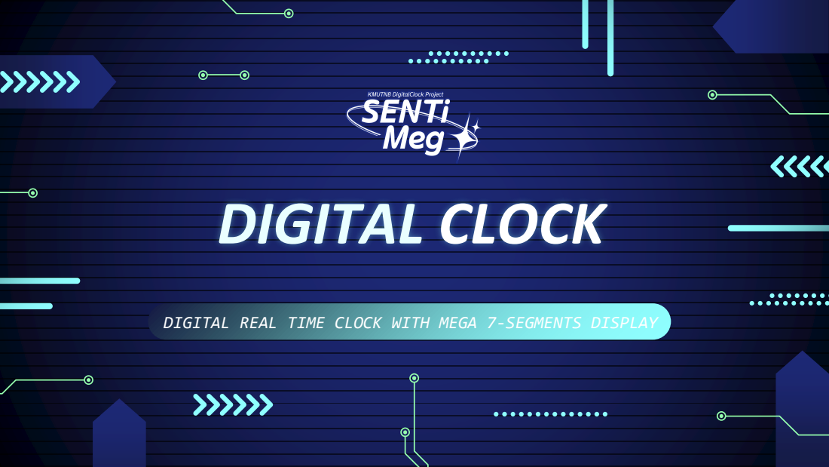
[picture p55: page 2]
DIGITAL CLOCK

DIGITAL REAL TIME CLOCK WITH MEGA 7-SEGMENTS DISPLAY

# TABLE OF CONTENTS

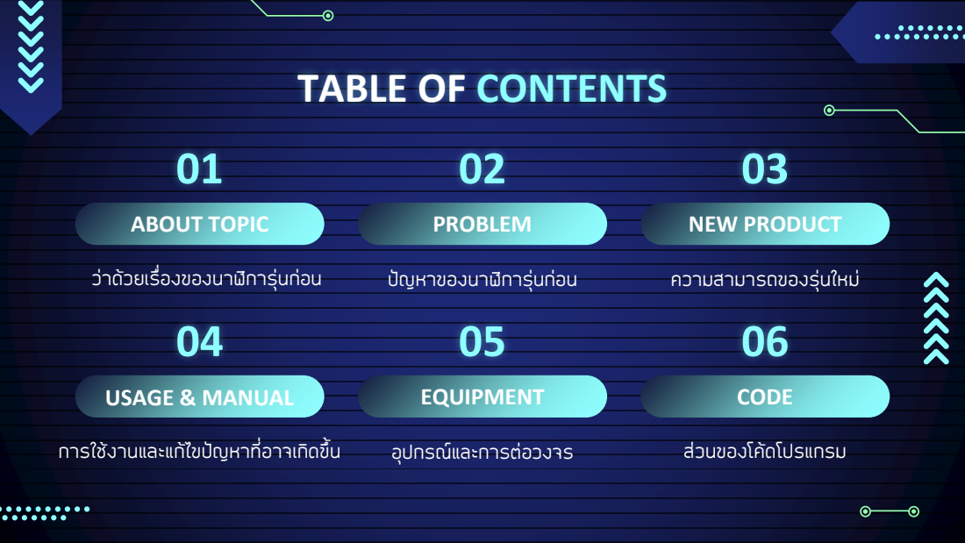
[picture p56: page 3]
ABOUT TOPIC; PROBLEM; NEW PRODUCT; ความสามารถของรุ่นใหม่; USAGE & MANUAL; EQUIPMENT; CODE; ส่วนของโค้ดโปรแกรม

ว่าด้วยเรื่องของนาฬิการุ่นก่อน

ปัญหาของนาฬิการุ่นก่อน

การใช้งานและแก้ไขปัญหาที่อาจเกิดขึ้น

อุปกรณ์และการต่อวงจร

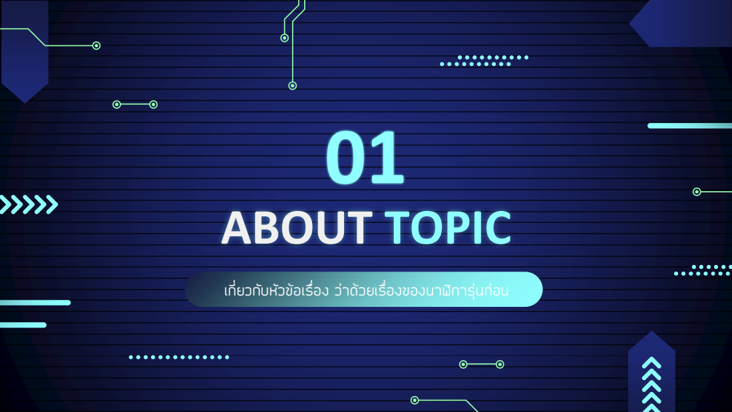
[picture p57: page 4]
ABOUT TOPIC

เกี่ยวกับหัวข้อเรื่อง ว่าด้วยเรื่องของนาฬิการุ่นก่อน

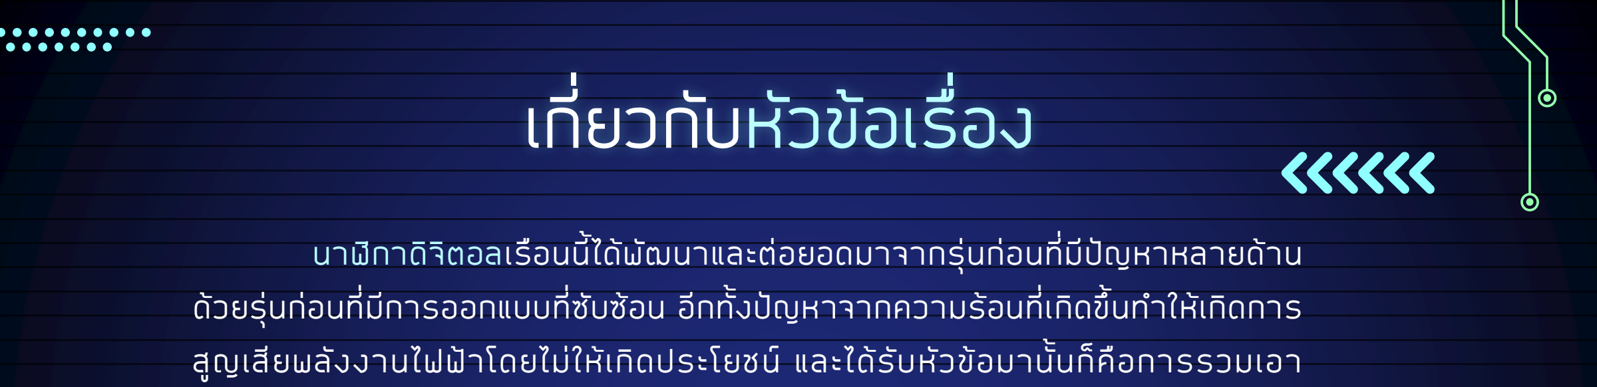
[picture p58: figure]
เกี่ยวกับหัวข้อเรื่อง; นาฬิกาดิจิตอลเรือนนี้ได้พัฒนาและต่อยอดมาจากรุ่นก่อนที่มีปัญหาหลายด้าน; ด้วยรุ่นก่อนที่มีการออกแบบที่ซับซ้อน อีกทั้งปัญหาจากความร้อนที่เกิดขึ้นท าให้เกิดการ; สูญเสียพลังงานไฟฟ้าโดยไม่ให้เกิดประโยชน์ และได้รับหัวข้อมานั้นก็คือการรวมเอา

ไมโครคอนโทรลเลอร์สองตัวมารวมกันให้เป็นหนึ่ง

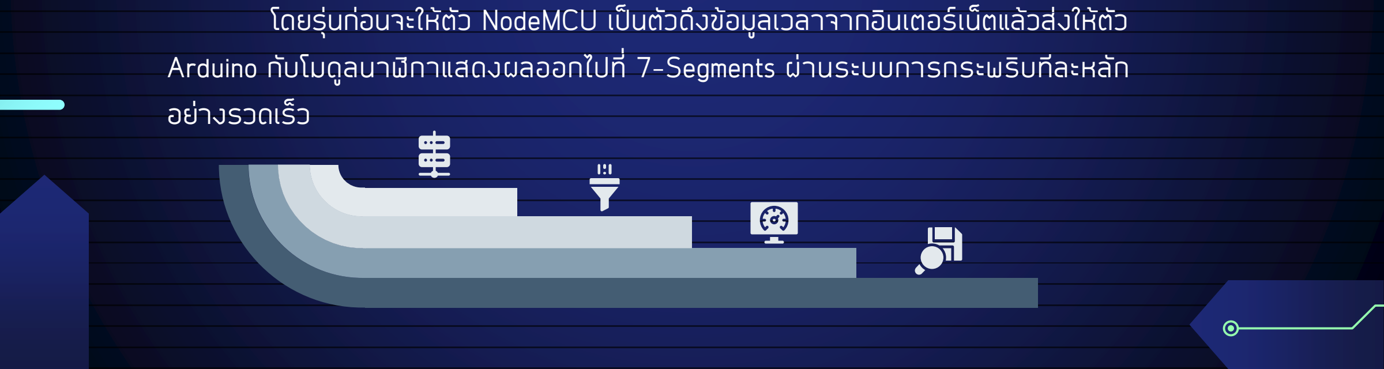
[picture p59: figure]
โดยรุ่นก่อนจะให้ตัว NodeMCU เป็นตัวดึงข้อมูลเวลาจากอินเตอร์เน็ตแล้วส่งให้ตัว; Arduino กับโมดูลนาฬิกาแสดงผลออกไปที่ 7-Segments ผ่านระบบการกระพริบทีละหลัก; อย่างรวดเร็ว
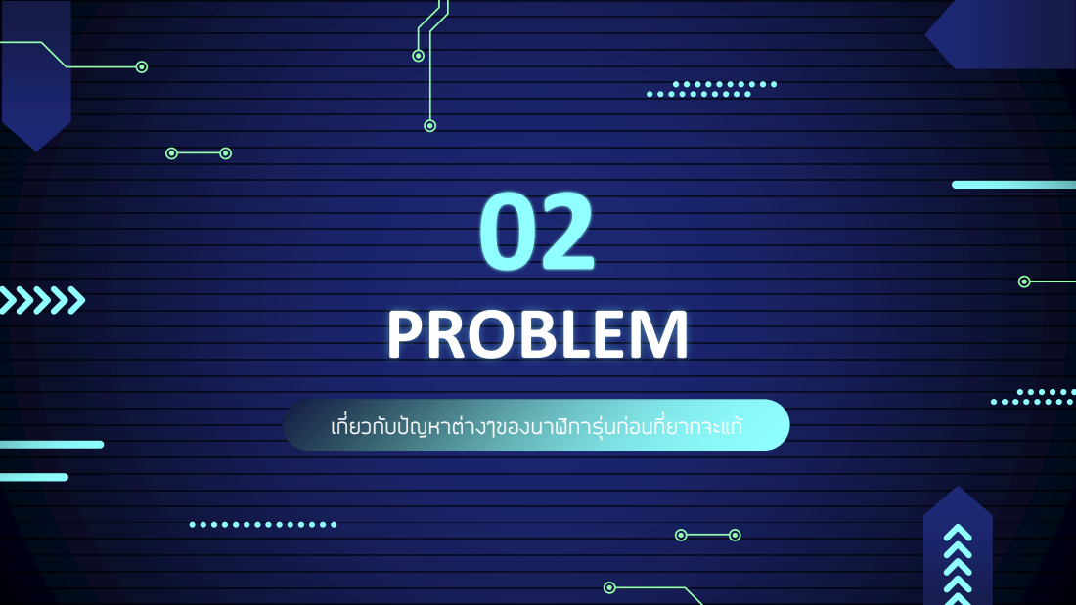
[picture p60: page 6]
PROBLEM

เกี่ยวกับปัญหาต่างๆของนาฬิการุ่นก่อนที่ยากจะแก้

# ปัญหาที่เกิดขึ้น

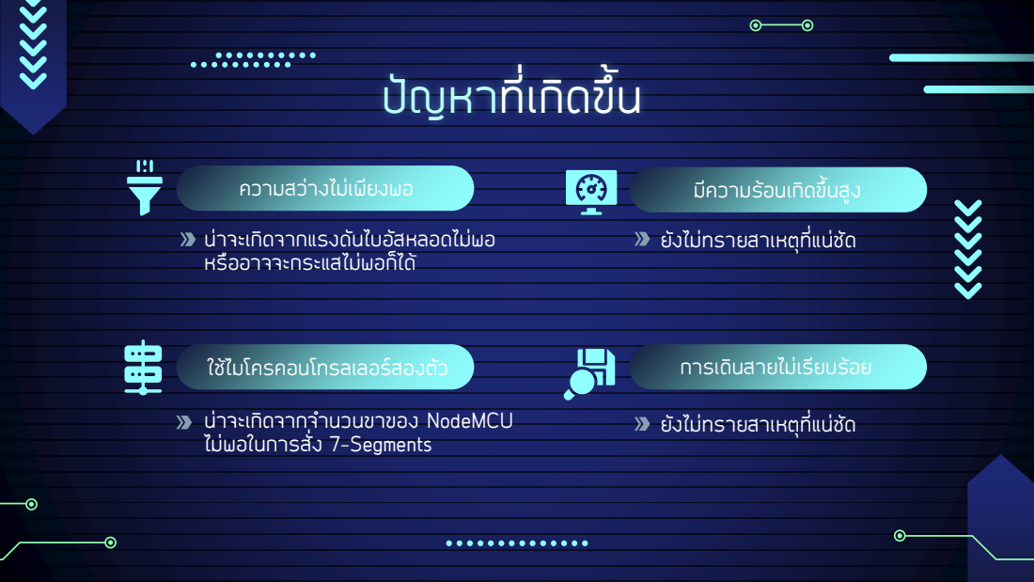
[picture p61: page 7]
ความสว่างไม่เพียงพอ; มีความร้อนเกิดขึ้นสูง; ใช้ไมโครคอนโทรลเลอร์สองตัว; การเดินสายไม่เรียบร้อย; น่าจะเกิดจากจ านวนขาของ NodeMCU; ยังไม่ทรายสาเหตุที่แน่ชัด ไม่พอในการสั่ง 7-Segments

ยังไม่ทรายสาเหตุที่แน่ชัด

น่าจะเกิดจากแรงดันไบอัสหลอดไม่พอ
หรืออาจจะกระแสไม่พอก็ได้

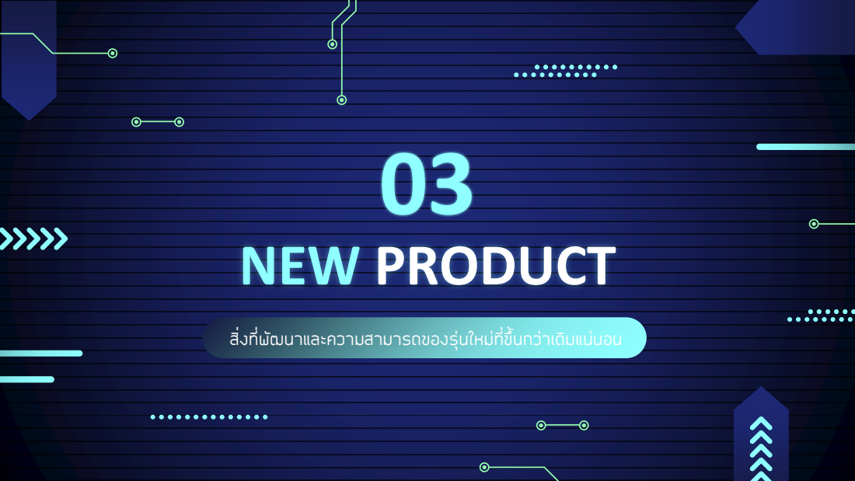
[picture p62: page 8]
NEW PRODUCT

สิ่งที่พัฒนาและความสามารถของรุ่นใหม่ที่ขึ้นกว่าเดิมแน่นอน

# ABOUT PRODUCT

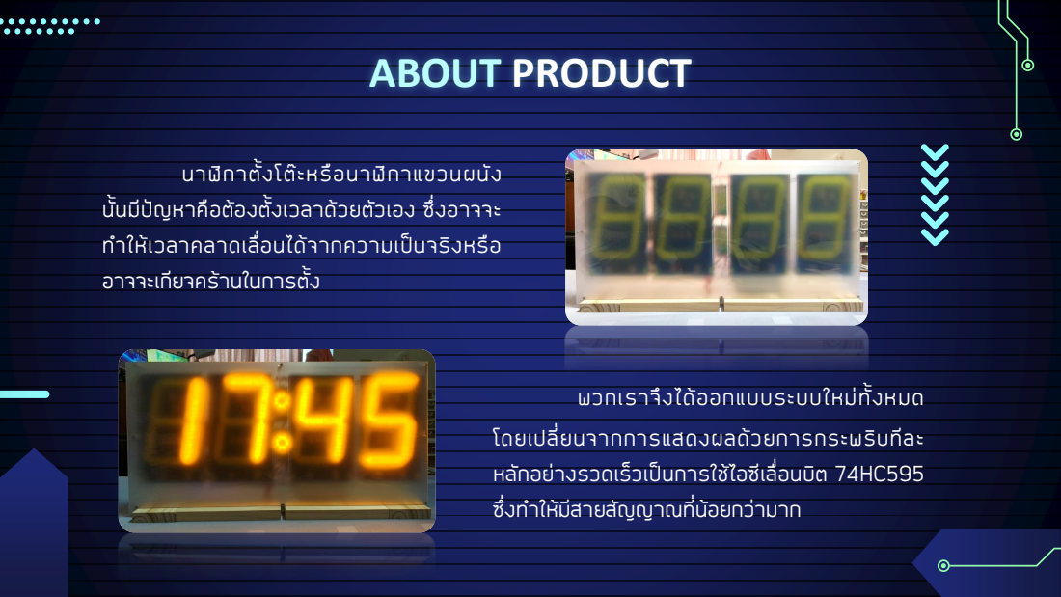
[picture p63: page 9]

นาฬิกาตั้งโต๊ะหรือนาฬิกาแขวนผนัง

นั้นมีปัญหาคือต้องตั้งเวลาด้วยตัวเอง ซึ่งอาจจะ
ท าให้เวลาคลาดเลื่อนได้จากความเป็นจริงหรือ
อาจจะเกียจคร้านในการตั้ง

พวกเราจึงได้ออกแบบระบบใหม่ทั้งหมด

โดยเปลี่ยนจากการแสดงผลด้วยการกระพริบทีละ
หลักอย่างรวดเร็วเป็นการใช้ไอซีเลื่อนบิต 74HC595
ซึ่งท าให้มีสายสัญญาณที่น้อยกว่ามาก

# ไอซีเลื่อนบิต 74HC595

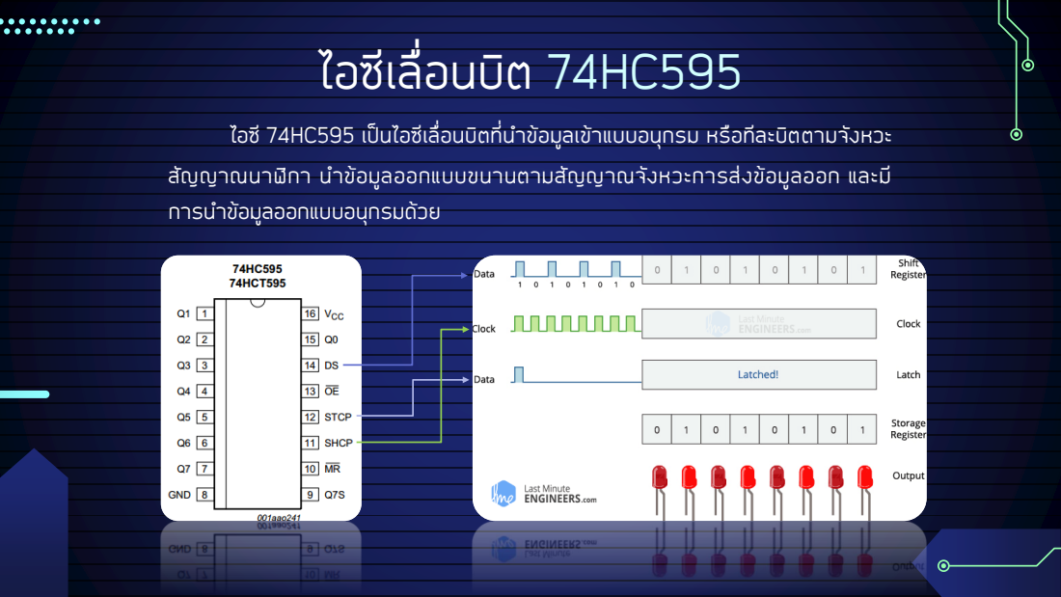
[picture p64: page 10]

ไอซี 74HC595 เป็นไอซีเลื่อนบิตที่น าข้อมูลเข้าแบบอนุกรม หรือทีละบิตตามจังหวะ

สัญญาณนาฬิกา น าข้อมูลออกแบบขนานตามสัญญาณจังหวะการส่งข้อมูลออก และมี
การน าข้อมูลออกแบบอนุกรมด้วย

# ความสามารถในการท างาน

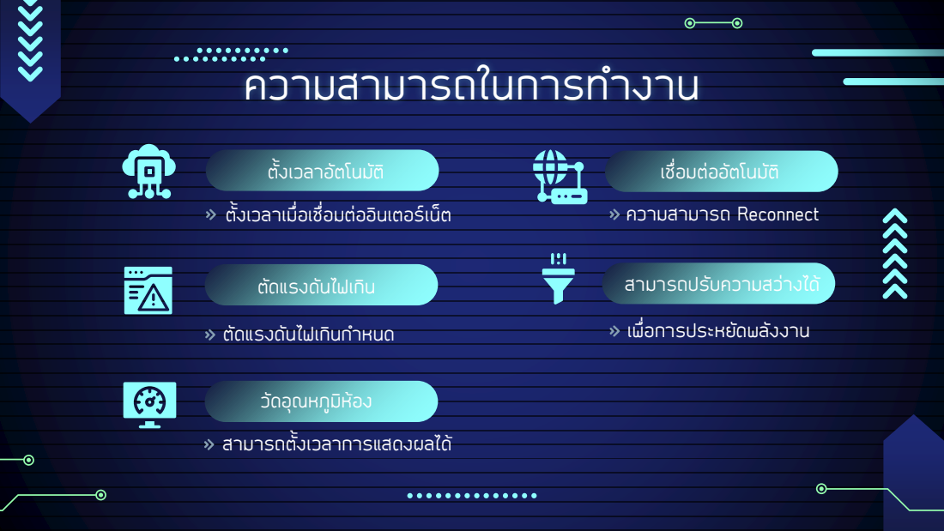
[picture p65: page 11]
ตั้งเวลาอัตโนมัติ; ตัดแรงดันไฟเกิน; ความสามารถ Reconnect; สามารถตั้งเวลาการแสดงผลได้

เชื่อมต่ออัตโนมัติ

ตั้งเวลาเมื่อเชื่อมต่ออินเตอร์เน็ต

สามารถปรับความสว่างได้

เพื่อการประหยัดพลังงาน

ตัดแรงดันไฟเกินก าหนด

วัดอุณหภูมิห้อง

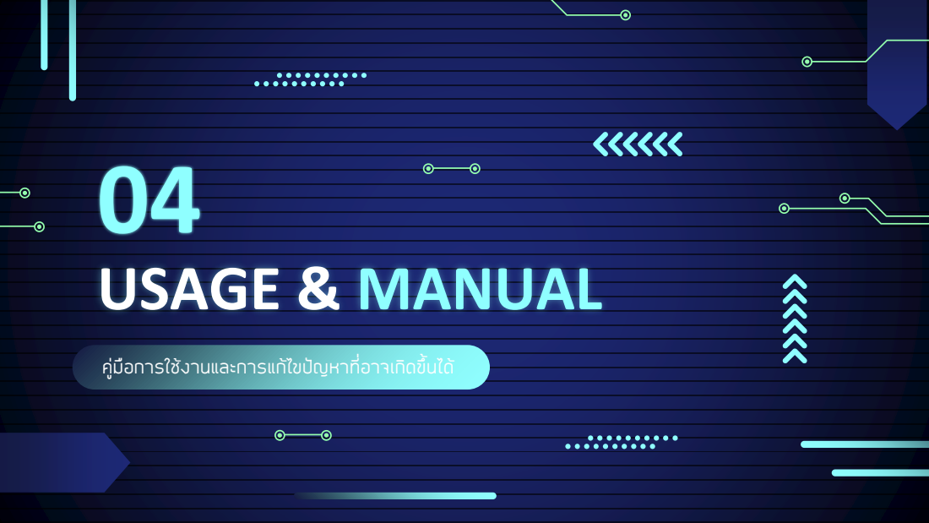
[picture p66: page 12]
USAGE & MANUAL

คู่มือการใช้งานและการแก้ไขปัญหาที่อาจเกิดขึ้นได้

# การใช้งาน Buck Converter

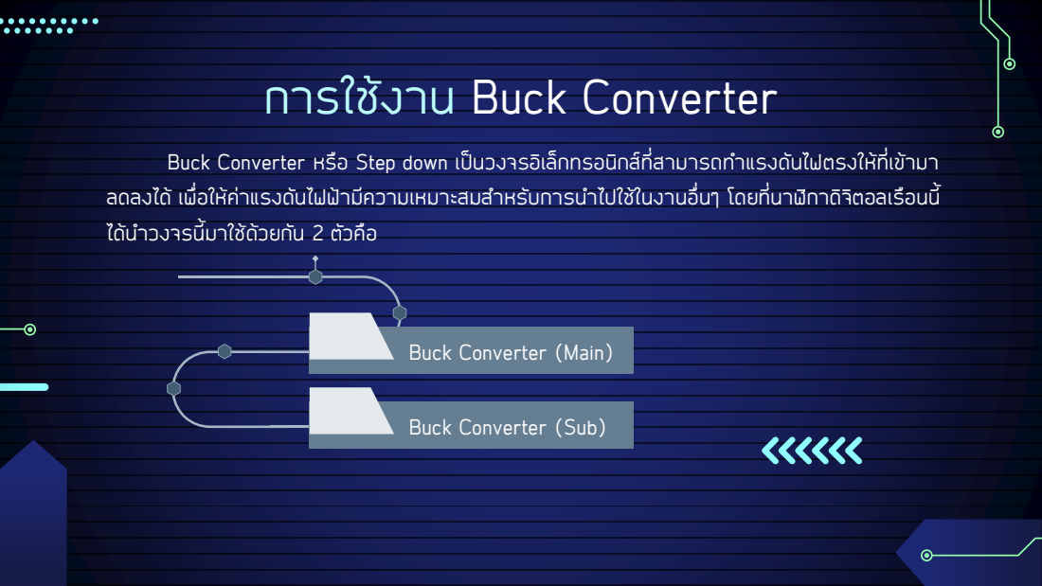
[picture p67: page 13]

Buck Converter หรือ Step down เป็นวงจรอิเล็กทรอนิกส์ที่สามารถท าแรงดันไฟตรงให้ที่เข้ามา

ลดลงได้ เพื่อให้ค่าแรงดันไฟฟ้ามีความเหมาะสมส าหรับการน าไปใช้ในงานอื่นๆ โดยที่นาฬิกาดิจิตอลเรือนนี้
ได้น าวงจรนี้มาใช้ด้วยกัน 2 ตัวคือ

Buck Converter (Main)

Buck Converter (Sub)

# การใช้งาน Buck Converter (Main)

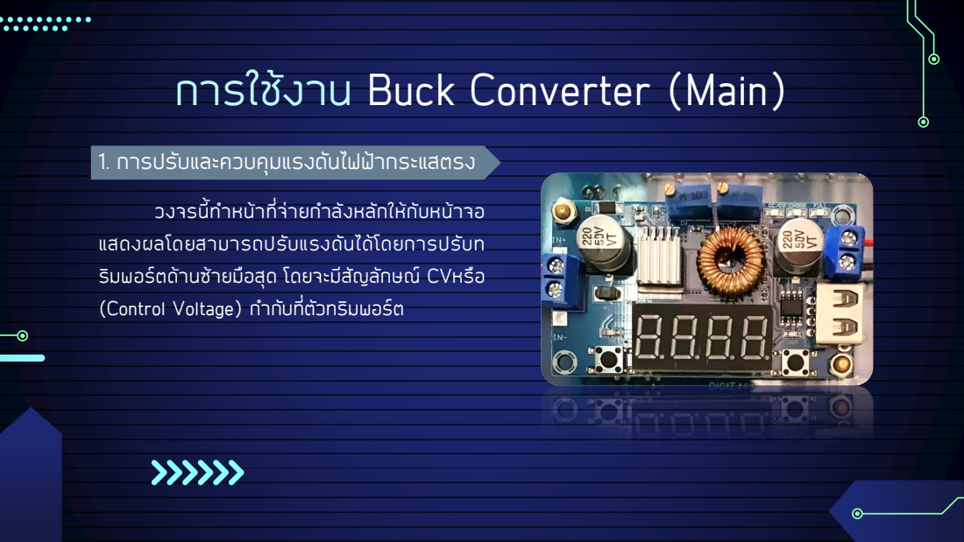
[picture p68: page 14]

1. การปรับและควบคุมแรงดันไฟฟ้ากระแสตรง

วงจรนี้ท าหน้าที่จ่ายก าลังหลักให้กับหน้าจอ

แสดงผลโดยสามารถปรับแรงดันได้โดยการปรับท
ริมพอร์ตด้านซ้ายมือสุด โดยจะมีสัญลักษณ์ CVหรือ
(Control Voltage) ก ากับที่ตัวทริมพอร์ต

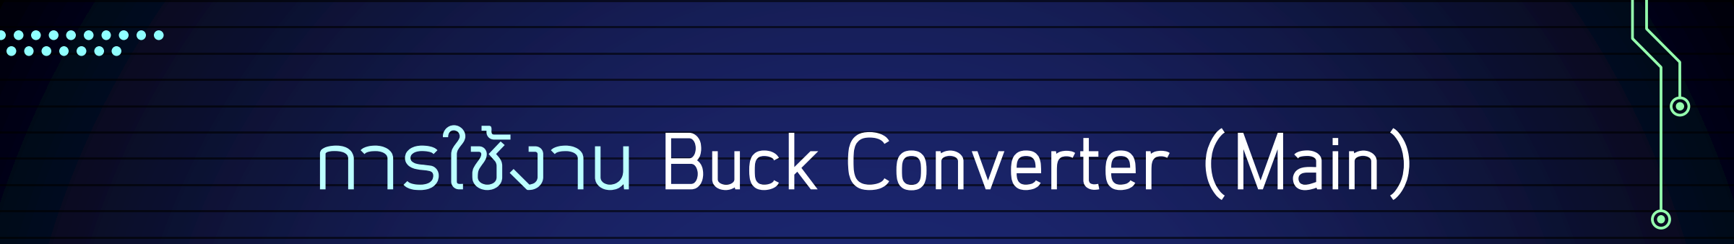
[picture p69: figure]
การใช้งาน Buck Converter (Main)
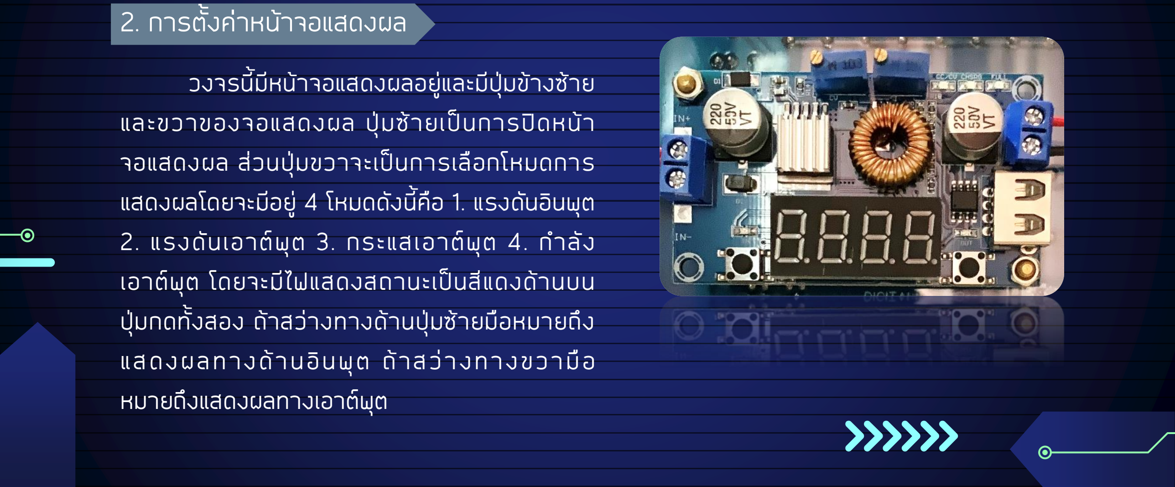
[picture p70: figure]
2. การตั้งค่าหน้าจอแสดงผล; วงจรนี้มีหน้าจอแสดงผลอยู่และมีปุ่มข้างซ้าย; และขวาของจอแสดงผล ปุ่มซ้ายเป็นการปิดหน้า; จอแสดงผล ส่วนปุ่มขวาจะเป็นการเลือกโหมดการ; แสดงผลโดยจะมีอยู่ 4 โหมดดังนี้คือ 1. แรงดันอินพุต; เอาต์พุต โดยจะมีไฟแสดงสถานะเป็นสีแดงด้านบน; ปุ่มกดทั้งสอง ถ้าสว่างทางด้านปุ่มซ้ายมือหมายถึง; หมายถึงแสดงผลทางเอาต์พุต

### 2. แรงดันเอาต์พุต 3. กระแสเอาต์พุต 4. ก าลัง

แส ด งผลท างด้ านอินพุต ถ้ าส ว่ า งท า ง ขว ามื อ

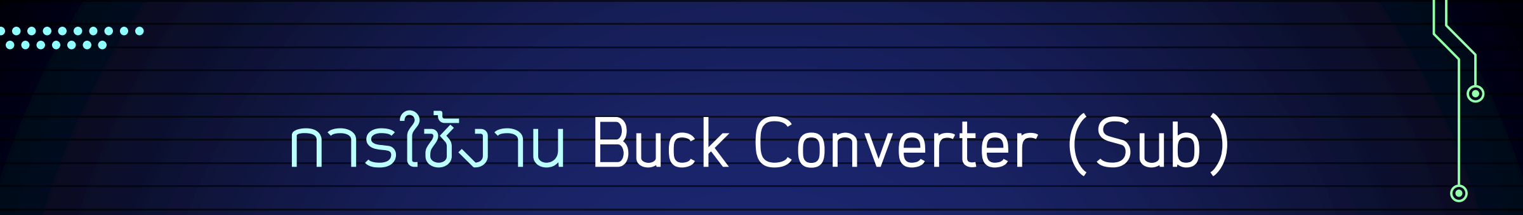
[picture p71: figure]
การใช้งาน Buck Converter (Sub)

### 1. การปรับและควบคุมแรงดันไฟฟ้ากระแสตรง

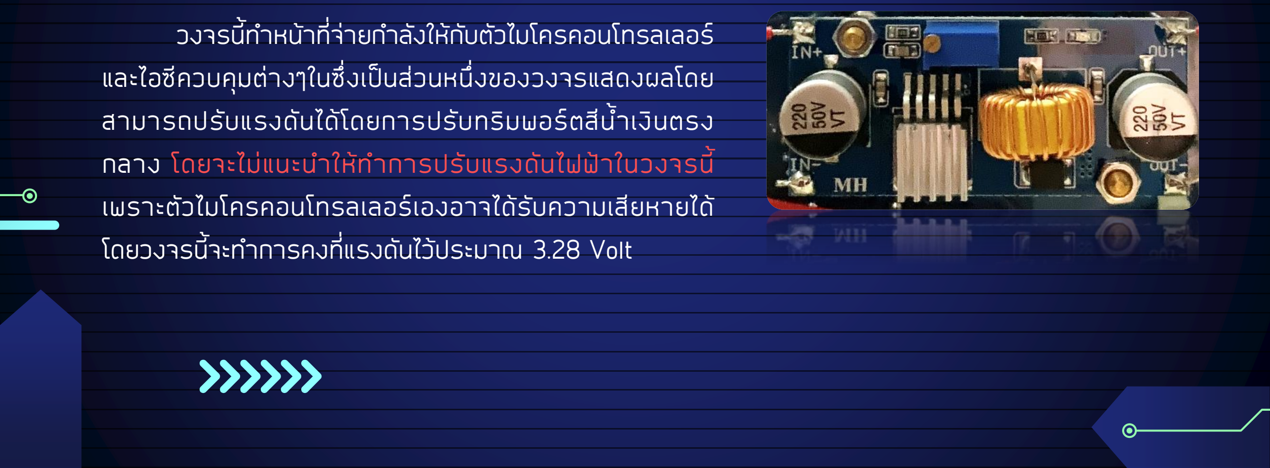
[picture p72: figure]
วงจรนี้ท าหน้าที่จ่ายก าลังให้กับตัวไมโครคอนโทรลเลอร์; และไอซีควบคุมต่างๆในซึ่งเป็นส่วนหนึ่งของวงจรแสดงผลโดย; สามารถปรับแรงดันได้โดยการปรับทริมพอร์ตสีน้ าเงินตรง; กลาง โดยจะไม่แนะน าให้ท าการปรับแรงดันไฟฟ้าในวงจรนี้; เพราะตัวไมโครคอนโทรลเลอร์เองอาจได้รับความเสียหายได้; โดยวงจรนี้จะท าการคงที่แรงดันไว้ประมาณ 3.28 Volt

# การเชื่อมต่อกับอินเตอร์เน็ต

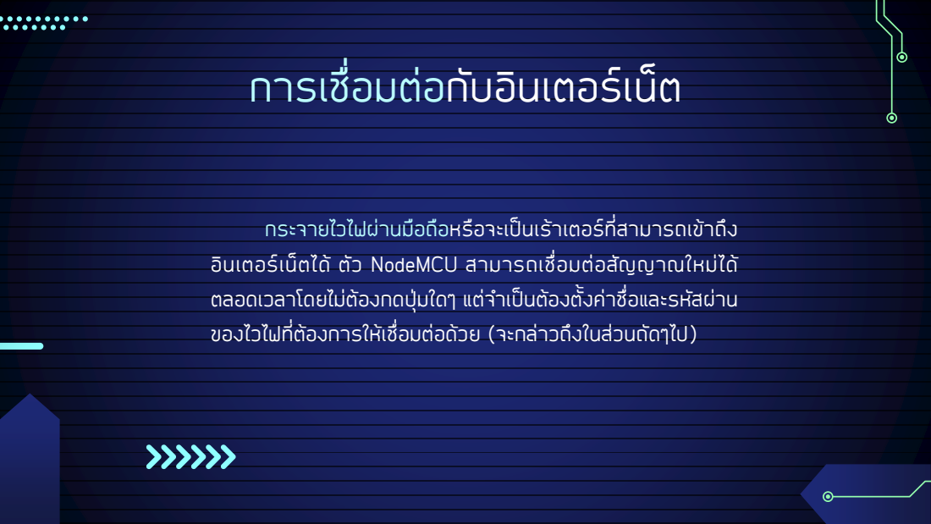
[picture p73: page 17]

กระจายไวไฟผ่านมือถือหรือจะเป็นเร้าเตอร์ที่สามารถเข้าถึง
อินเตอร์เน็ตได้ ตัว NodeMCU สามารถเชื่อมต่อสัญญาณใหม่ได้
ตลอดเวลาโดยไม่ต้องกดปุ่มใดๆ แต่จ าเป็นต้องตั้งค่าชื่อและรหัสผ่าน
ของไวไฟที่ต้องการให้เชื่อมต่อด้วย (จะกล่าวถึงในส่วนถัดๆไป)

# การปรับความสว่างการแสดงผล

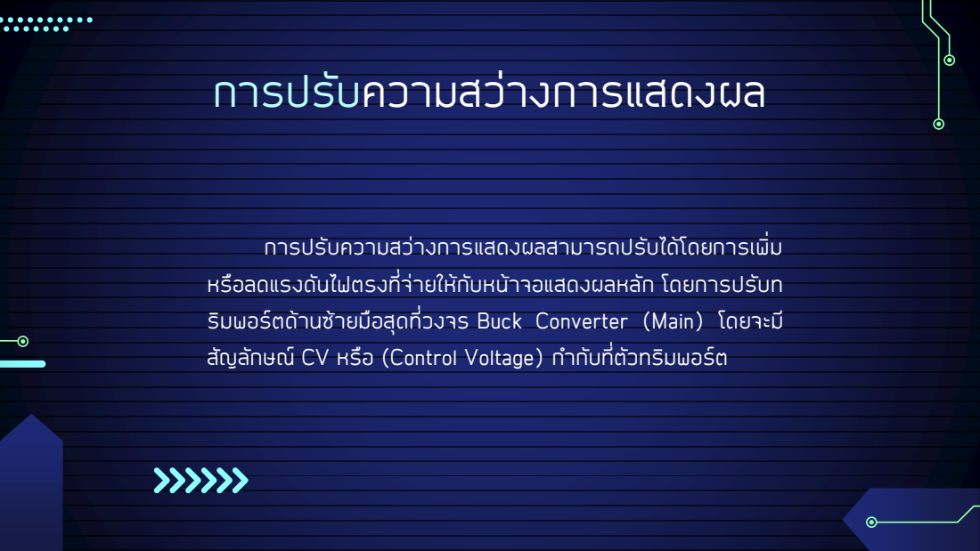
[picture p74: page 18]

การปรับความสว่างการแสดงผลสามารถปรับได้โดยการเพิ่ม
หรือลดแรงดันไฟตรงที่จ่ายให้กับหน้าจอแสดงผลหลัก โดยการปรับท
ริมพอร์ตด้านซ้ายมือสุดที่วงจร Buck Converter (Main) โดยจะมี
สัญลักษณ์ CV หรือ (Control Voltage) ก ากับที่ตัวทริมพอร์ต

# การก าหนดความสว่างสูงสุดให้กับหน้าจอแสดงผล

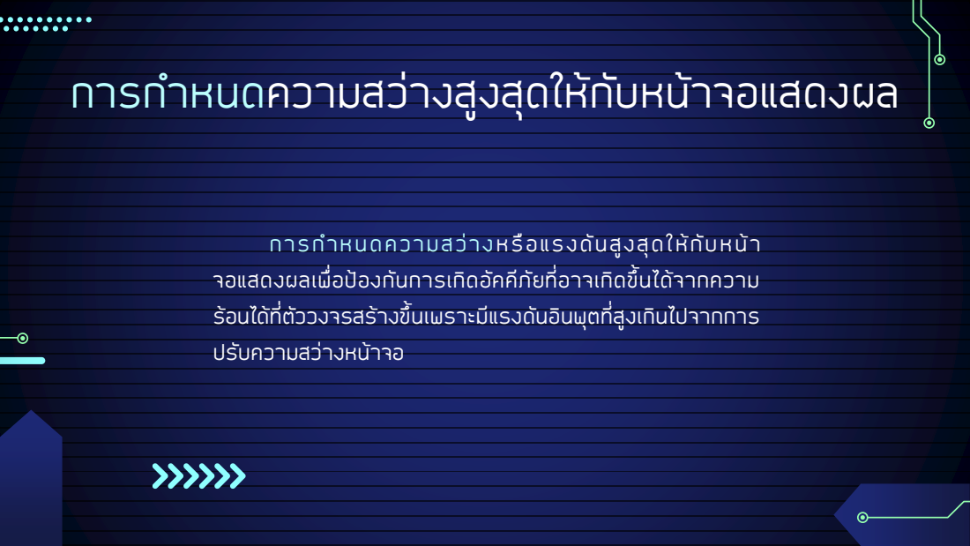
[picture p75: page 19]

การก าหนดความสว่างหรือแรงดันสูงสุด ให้กับหน้ า
จอแสดงผลเพื่อป้องกันการเกิดอัคคีภัยที่อาจเกิดขึ้นได้จากความ
ร้อนได้ที่ตัววงจรสร้างขึ้นเพราะมีแรงดันอินพุตที่สูงเกินไปจากการ

ปรับความสว่างหน้าจอ

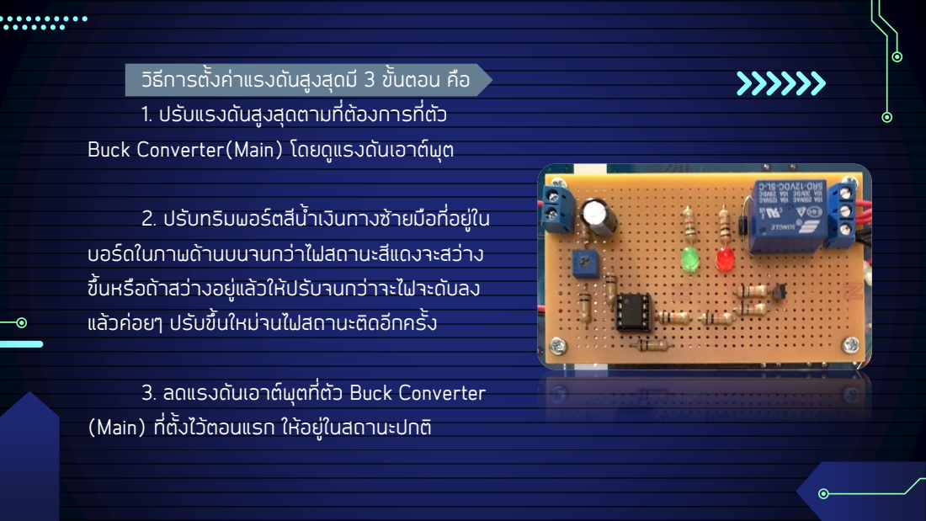
[picture p76: page 20]

วิธีการตั้งค่าแรงดันสูงสุดมี 3 ขั้นตอน คือ
1. ปรับแรงดันสูงสุดตามที่ต้องการที่ตัว

Buck Converter(Main) โดยดูแรงดันเอาต์พุต

2. ปรับทริมพอร์ตสีน้ าเงินทางซ้ายมือที่อยู่ใน

บอร์ดในภาพด้านบนจนกว่าไฟสถานะสีแดงจะสว่าง
ขึ้นหรือถ้าสว่างอยู่แล้วให้ปรับจนกว่าจะไฟจะดับลง
แล้วค่อยๆ ปรับขึ้นใหม่จนไฟสถานะติดอีกครั้ง

3. ลดแรงดันเอาต์พุตที่ตัว Buck Converter
(Main) ที่ตั้งไว้ตอนแรก ให้อยู่ในสถานะปกติ

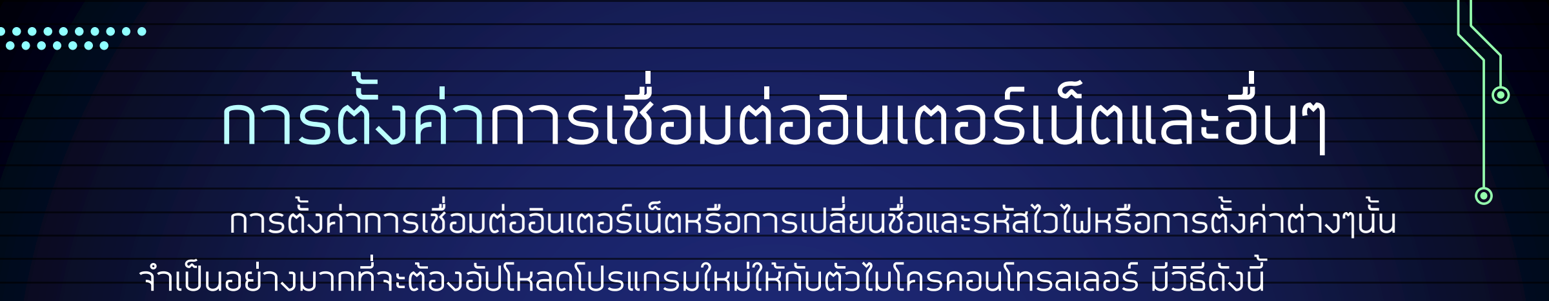
[picture p77: figure]
การตั้งค่าการเชื่อมต่ออินเตอร์เน็ตหรือการเปลี่ยนชื่อและรหัสไวไฟหรือการตั้งค่าต่างๆนั้น; จ าเป็นอย่างมากที่จะต้องอัปโหลดโปรแกรมใหม่ให้กับตัวไมโครคอนโทรลเลอร์ มีวิธีดังนี้

### 1. สแกน QR CODE ด้านหลังแผงวงจร หรือเข้าลิงก์

https://github.com/Natchpai/proDigialClockE31 (ไม่ใช่ proDigitalClockE31)

### 2. ไปที่โฟลเดอร์ CODE / FINAL_CODE_ClockProject ตามรูปด้านล่าง

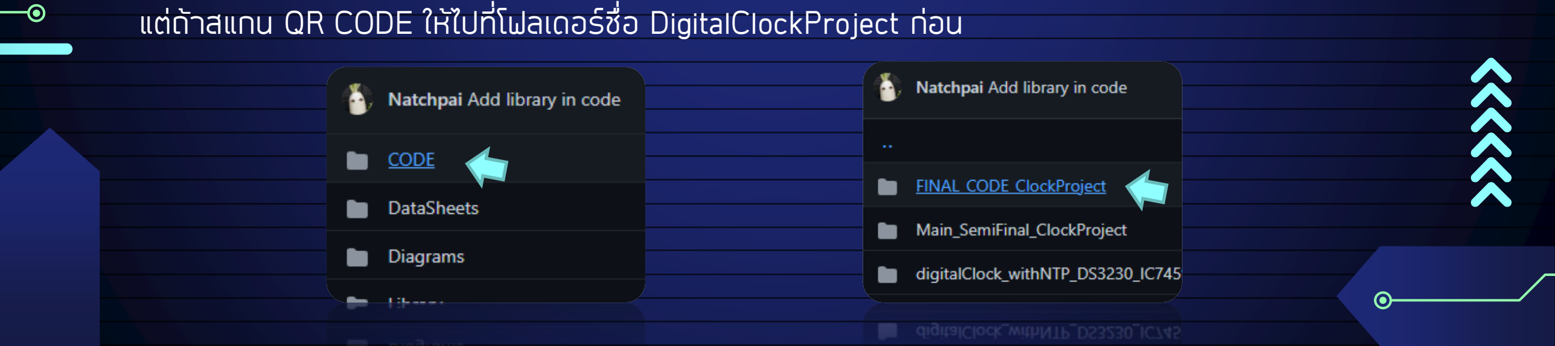
[picture p78: figure]

แต่ถ้าสแกน QR CODE ให้ไปที่โฟลเดอร์ชื่อ DigitalClockProject ก่อน

# การตั้งค่าการเชื่อมต่ออินเตอร์เน็ตและอื่นๆ

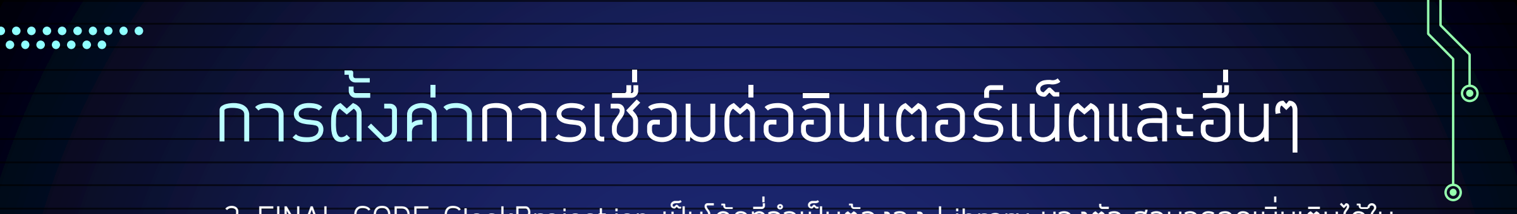
[picture p79: figure]

3. FINAL_CODE_ClockProject.ion เป็นโค้ดที่จ าเป็นต้องลง Library บางตัว สามารถดูเพิ่มเติมได้ใน

โค้ด ส่วนในโฟลเดอร์นี้จะมีมาให้ 2 ตัว สามารถลงได้เลย

4. สามารถเปลี่ยน SSID และ password แล้วอัปโหลดใหม่ได้เลย ส่วน pullData_hour คือการตั้งเวลา

ทุกๆกี่ชั่วโมง เมื่อมีการเชื่อมต่ออินเตอร์เน็ต ในที่นี้คือ ทุกๆ 6 ชม.

# การตั้งค่าการเชื่อมต่ออินเตอร์เน็ตและอื่นๆ

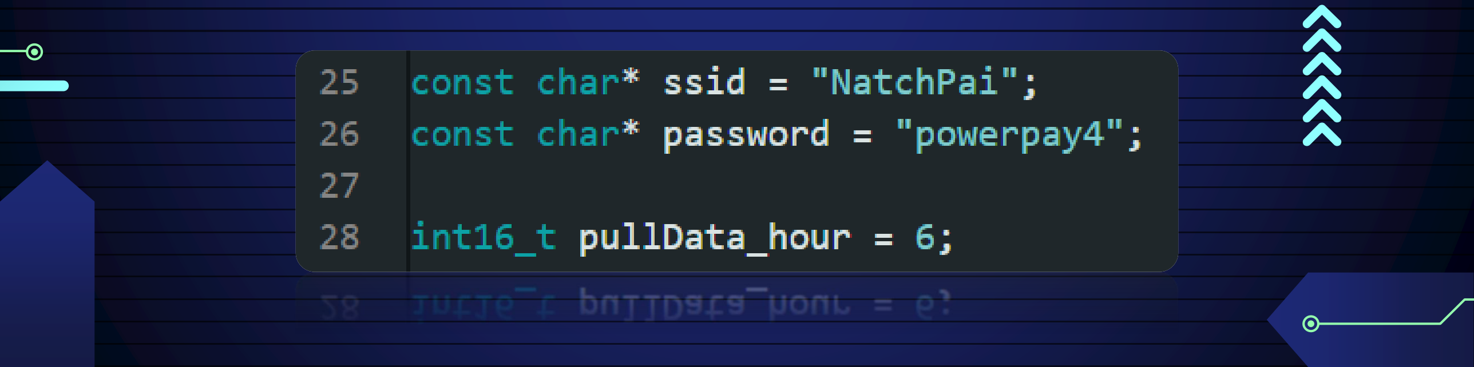
[picture p80: figure]

# การตั้งค่าการเชื่อมต่ออินเตอร์เน็ตและอื่นๆ

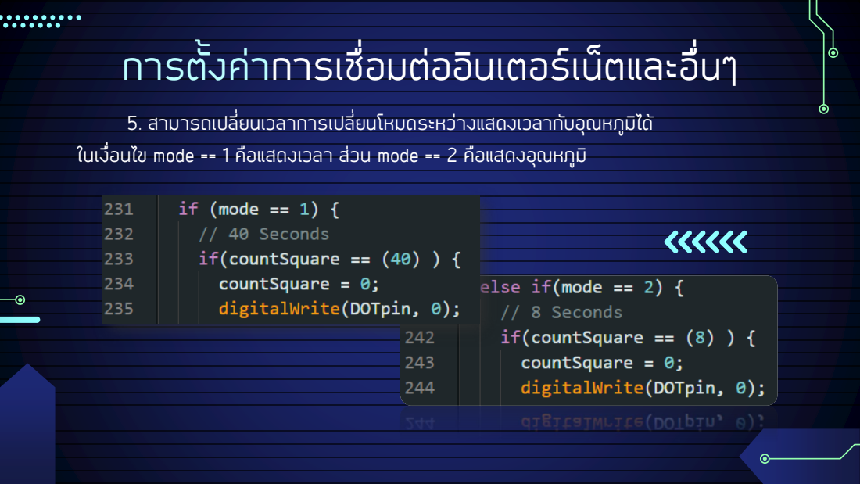
[picture p81: page 23]

5. สามารถเปลี่ยนเวลาการเปลี่ยนโหมดระหว่างแสดงเวลากับอุณหภูมิได้
ในเงื่อนไข mode == 1 คือแสดงเวลา ส่วน mode == 2 คือแสดงอุณหภูมิ

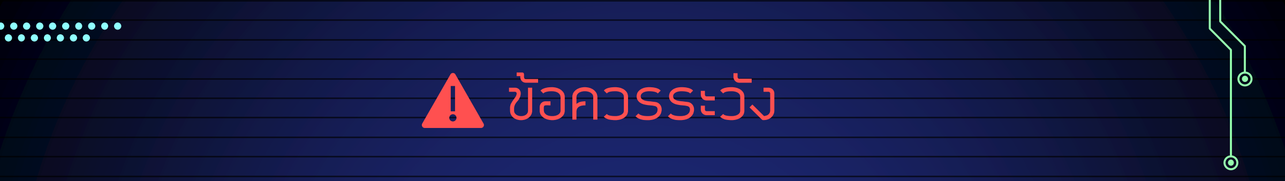
[picture p82: figure]
ข้อควรระวัง

### 1. ไม่แนะน าให้ปรับแรงดันที่วงจร Buck Converter (Sub) เพราะอาจจะท าให้วงจร

เสียหายได้ ซึ่งวงจรนี้จะคงแรงดันไว้ที่ 3.28 Volt โดยประมาณ

### 2. ไม่แนะน าให้ปรับ CC หรือ Control Current ที่วงจร Buck Converter (Main)

### 3. ไม่แนะน าให้ตั้ง CC หรือ CV ที่วงจร Buck Converter (Main) ผ่านการกดปุ่ม

### 4. อย่าปรับความสว่างหรือแรงดันมากจนเกินเพราะอาจเกิดอัคคีภัยได้

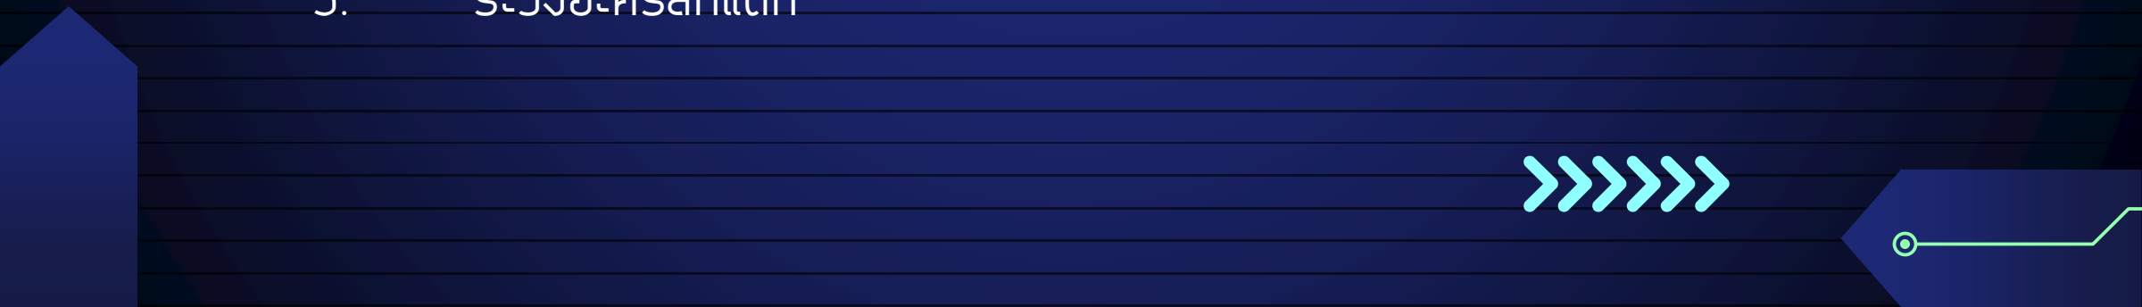
[picture p83: figure]

### 5. ระวังอะคริลิกแตก

# ปัญหาที่อาจเกิดขึ้นได้

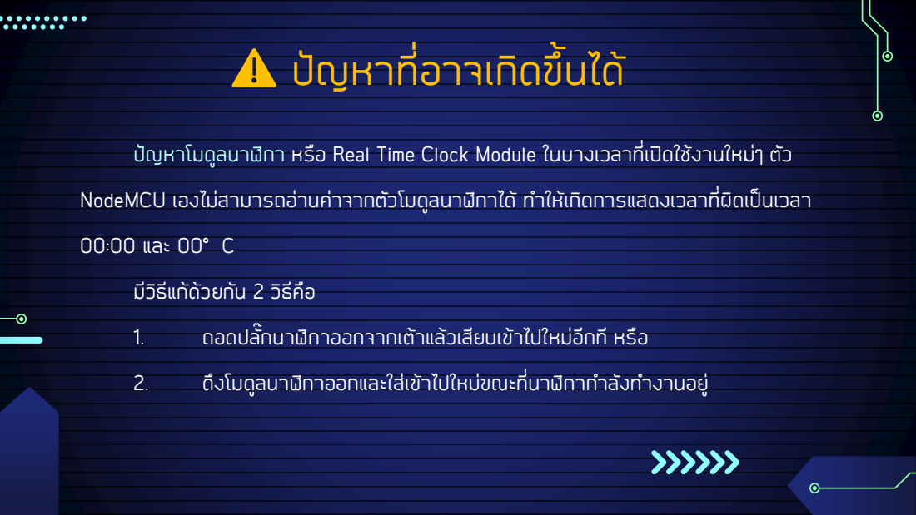
[picture p84: page 25]
00:00 และ 00°C; มีวิธีแก้ด้วยกัน 2 วิธีคือ

ปัญหาโมดูลนาฬิกา หรือ Real Time Clock Module ในบางเวลาที่เปิดใช้งานใหม่ๆ ตัว

NodeMCU เองไม่สามารถอ่านค่าจากตัวโมดูลนาฬิกาได้ ท าให้เกิดการแสดงเวลาที่ผิดเป็นเวลา

1. ถอดปลั๊กนาฬิกาออกจากเต้าแล้วเสียบเข้าไปใหม่อีกที หรือ

2. ดึงโมดูลนาฬิกาออกและใส่เข้าไปใหม่ขณะที่นาฬิกาก าลังท างานอยู่

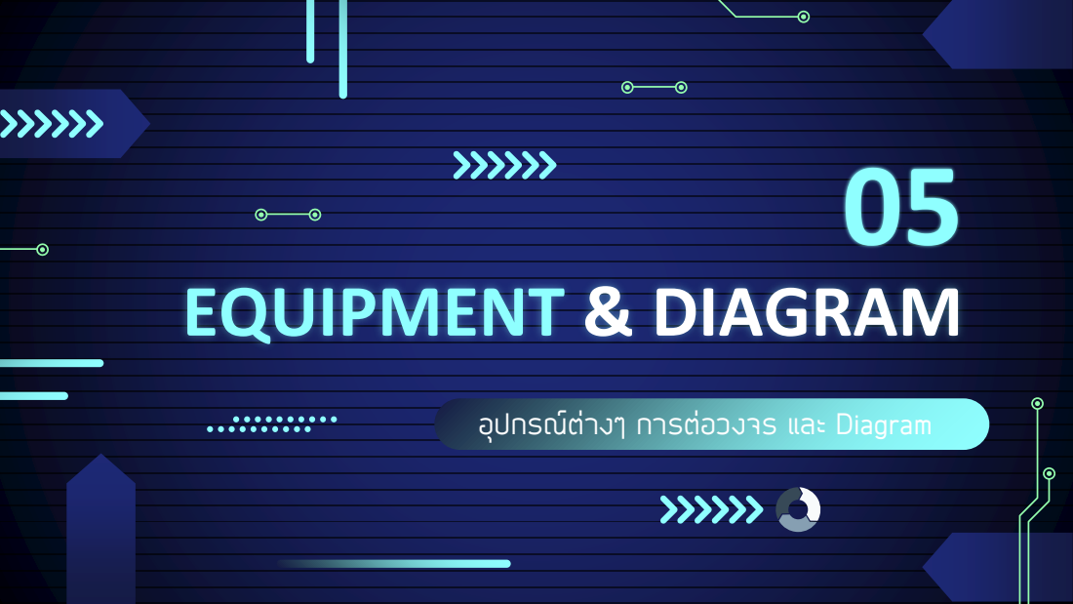
[picture p85: page 26]
EQUIPMENT & DIAGRAM

อุปกรณ์ต่างๆ การต่อวงจร และ Diagram

# ส่วนประกอบ

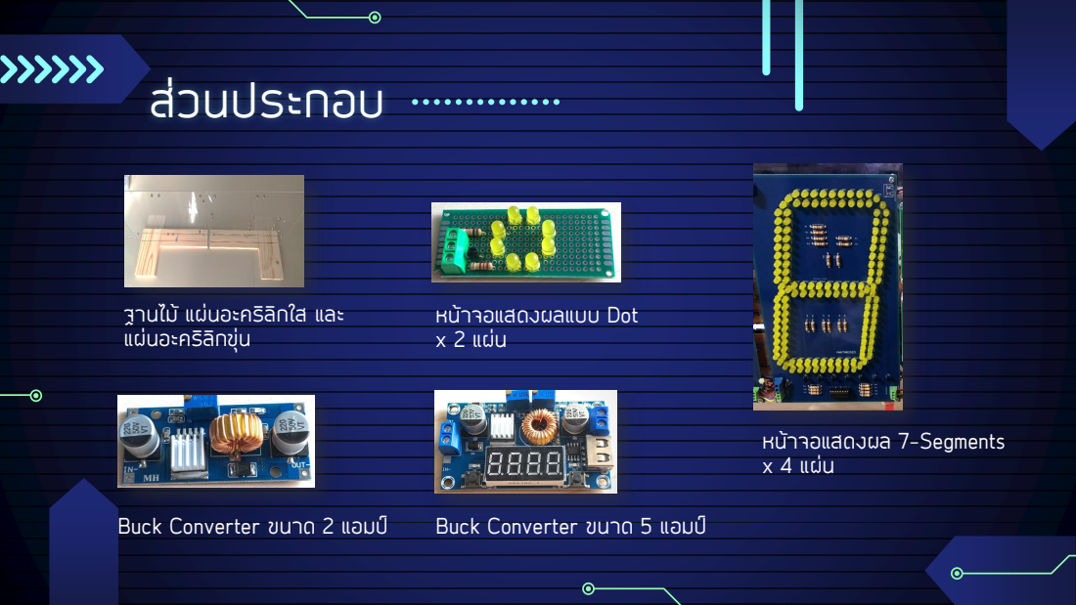
[picture p86: page 27]
Buck Converter ขนาด 2 แอมป์; Buck Converter ขนาด 5 แอมป์

ฐานไม้ แผ่นอะคริลิกใส และ
แผ่นอะคริลิกขุ่น

หน้าจอแสดงผลแบบ Dot

หน้าจอแสดงผล 7-Segments

# ส่วนประกอบ

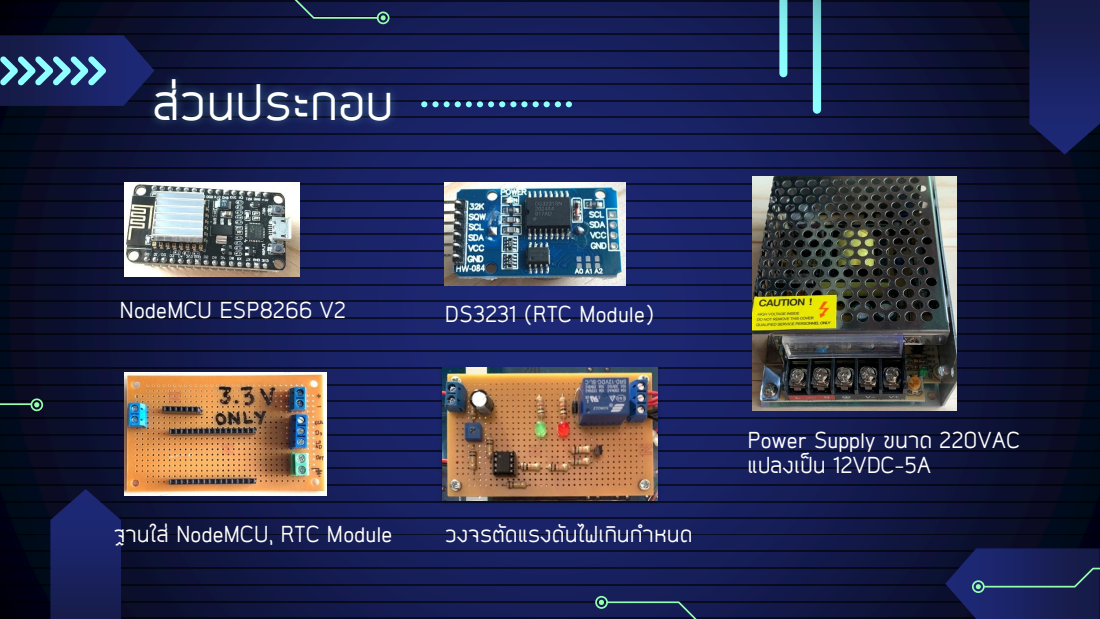
[picture p87: page 28]
NodeMCU ESP8266 V2; DS3231 (RTC Module); ฐานใส่ NodeMCU, RTC Module; วงจรตัดแรงดันไฟเกินก าหนด

Power Supply ขนาด 220VAC
แปลงเป็น 12VDC-5A

# DIAGRAM

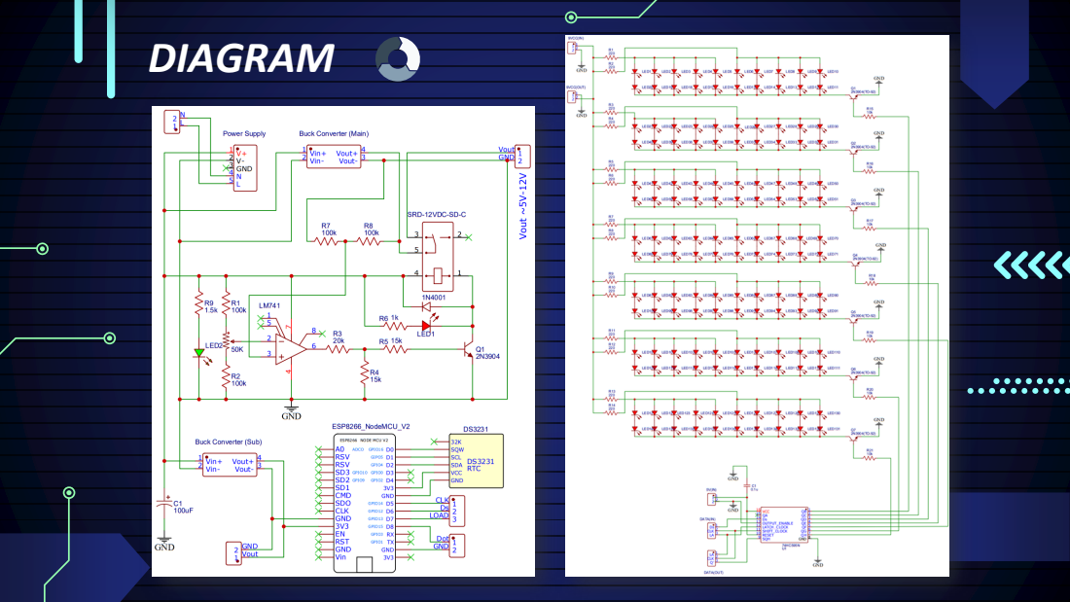
[picture p88: page 29]

# DIAGRAM

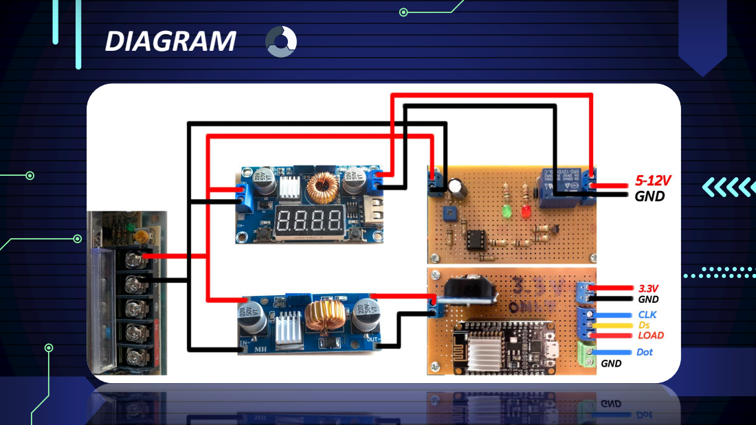
[picture p89: page 30]

# DIAGRAM

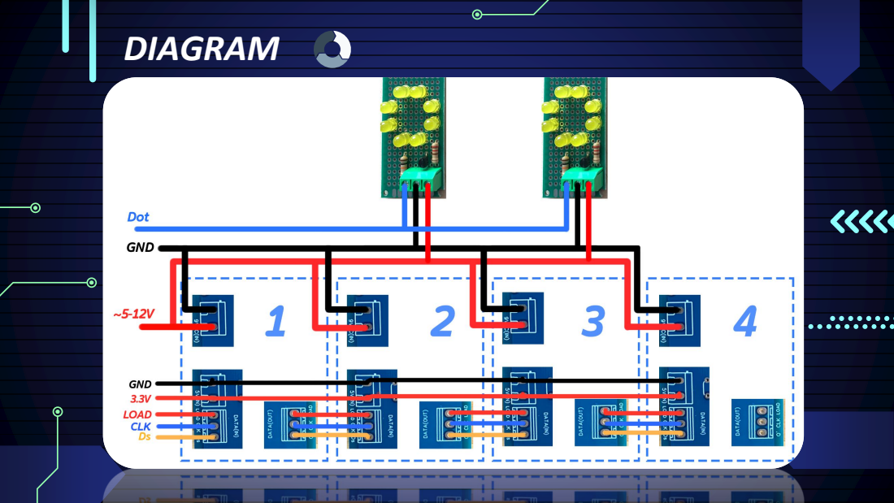
[picture p90: page 31]

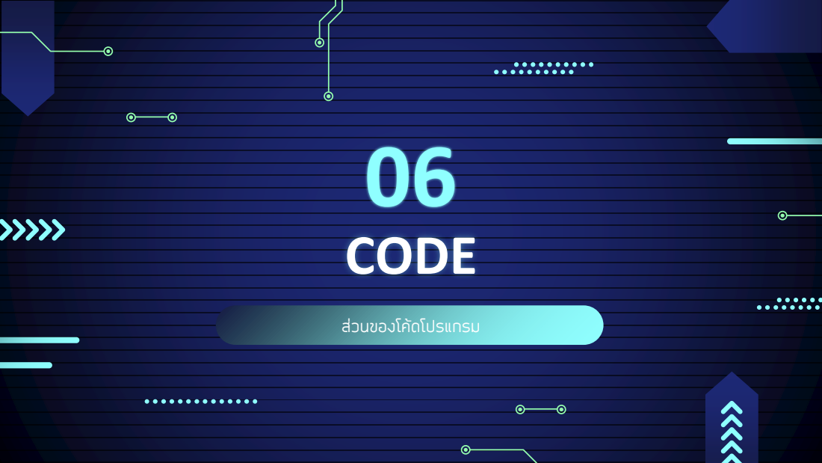
[picture p91: page 32]
CODE; ส่วนของโค้ดโปรแกรม

# CODE

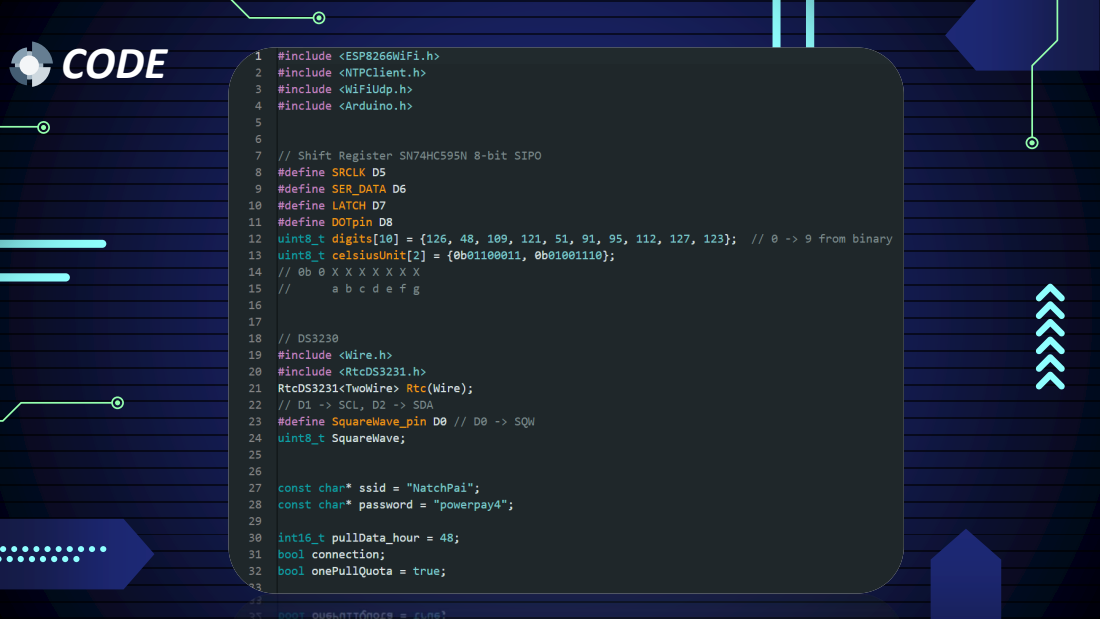
[picture p92: page 33]

# CODE

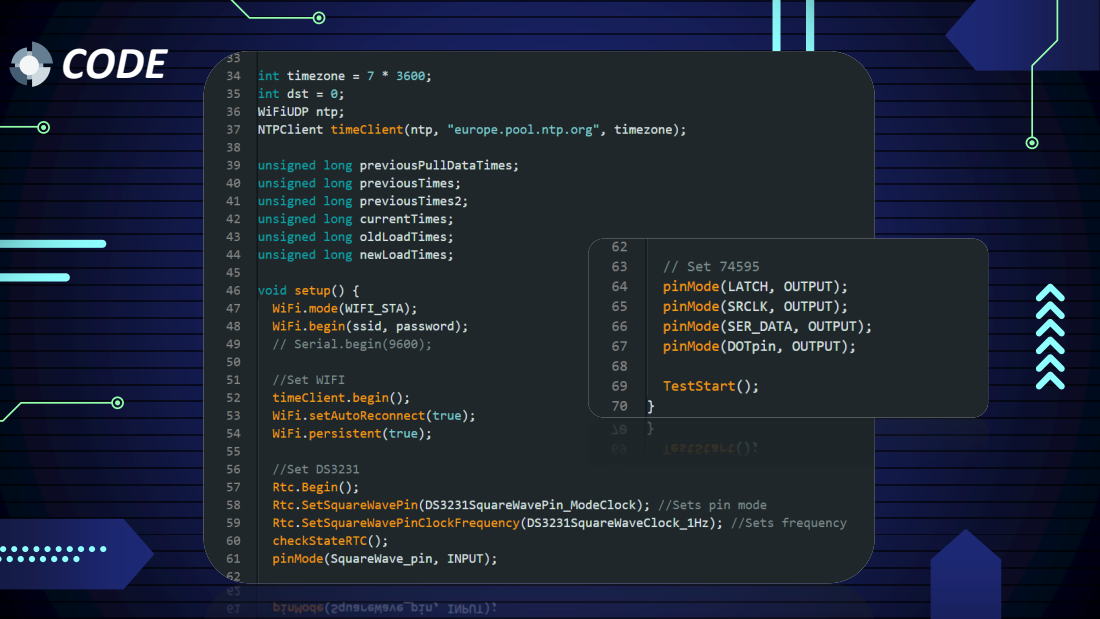
[picture p93: page 34]

# CODE

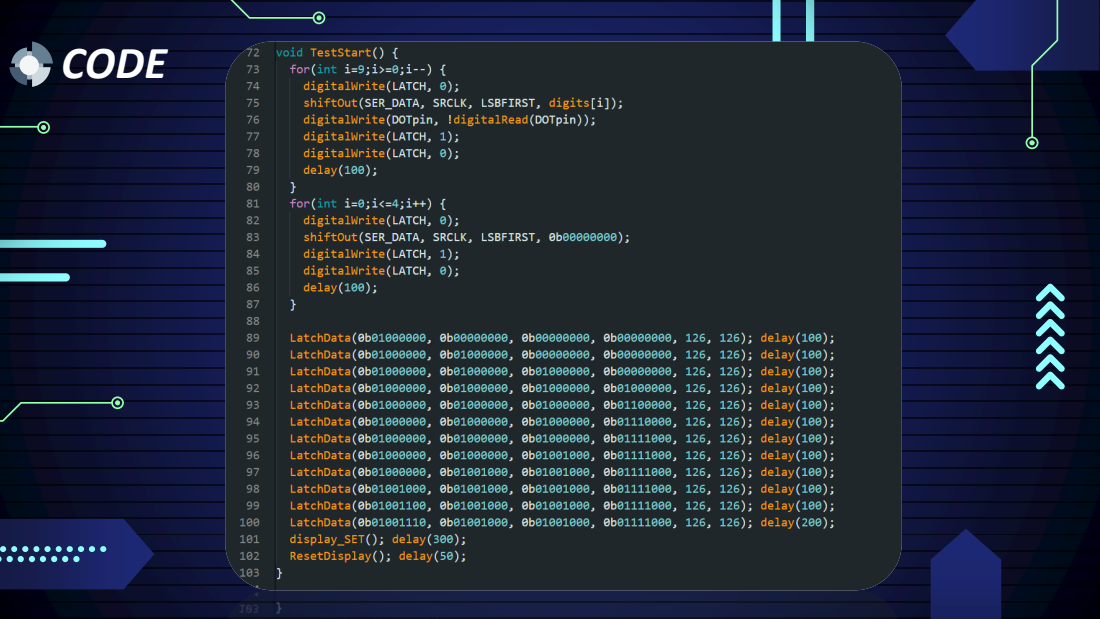
[picture p94: page 35]

# CODE

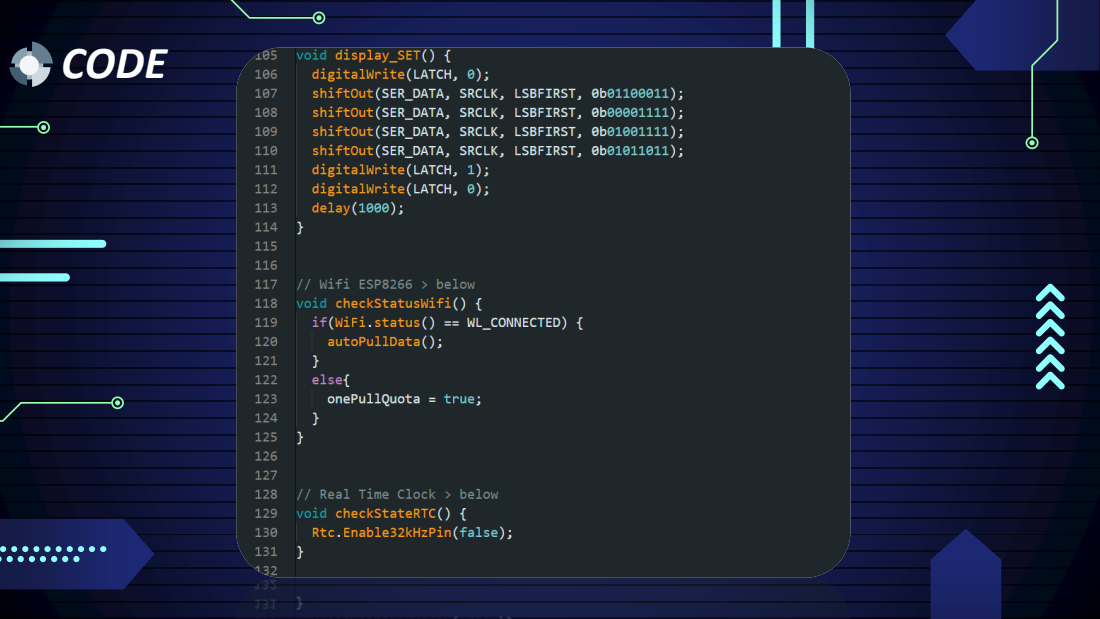
[picture p95: page 36]

# CODE

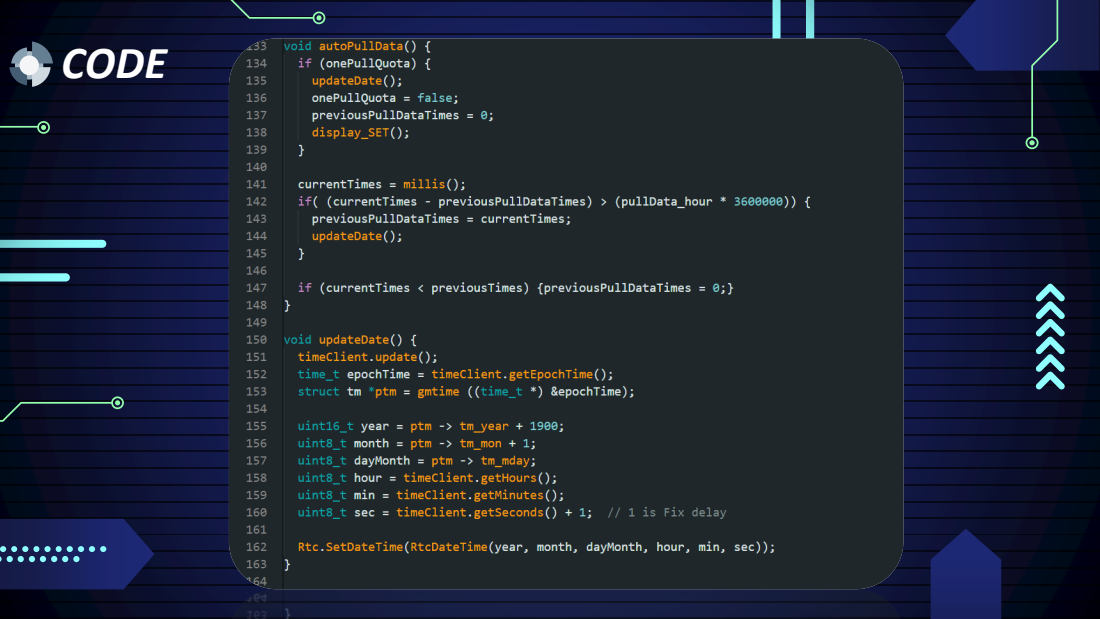
[picture p96: page 37]

# CODE

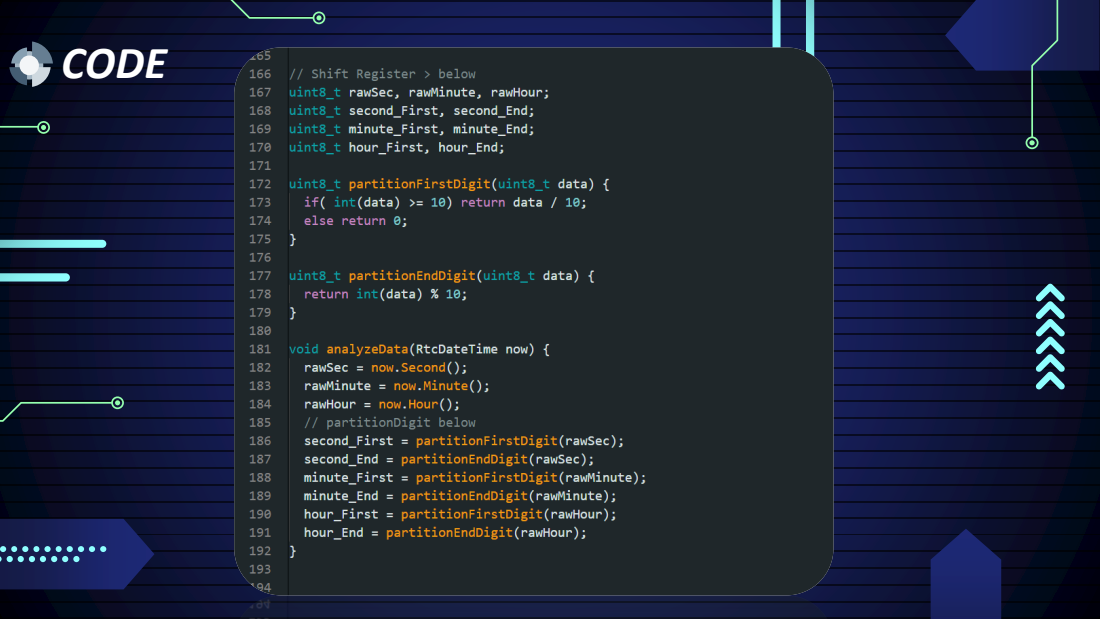
[picture p97: page 38]

# CODE

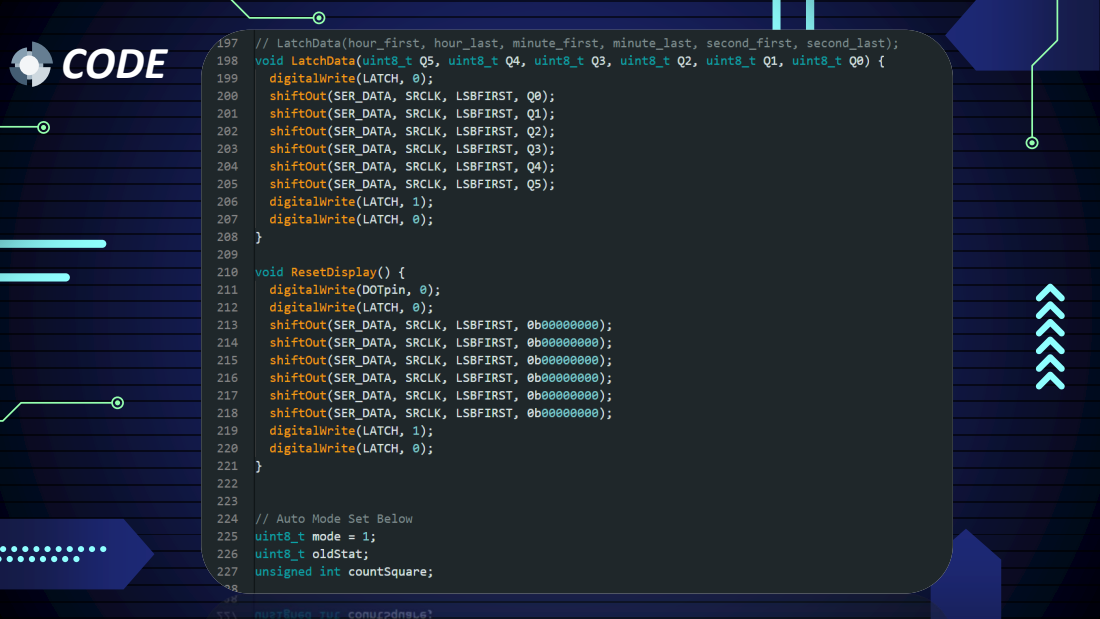
[picture p98: page 39]

# CODE

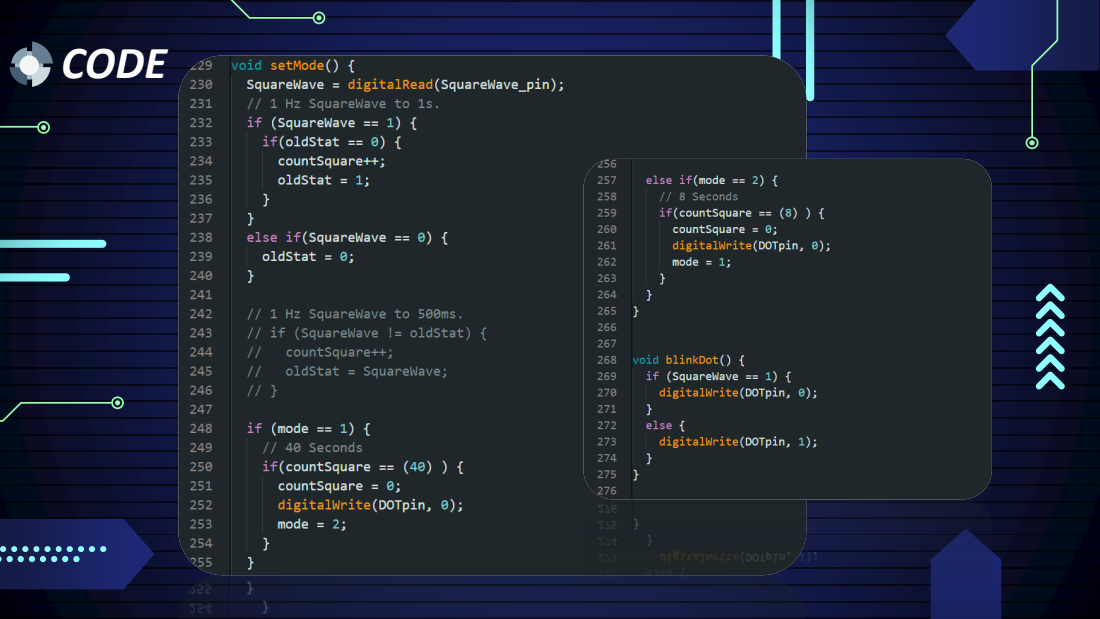
[picture p99: page 40]

# CODE

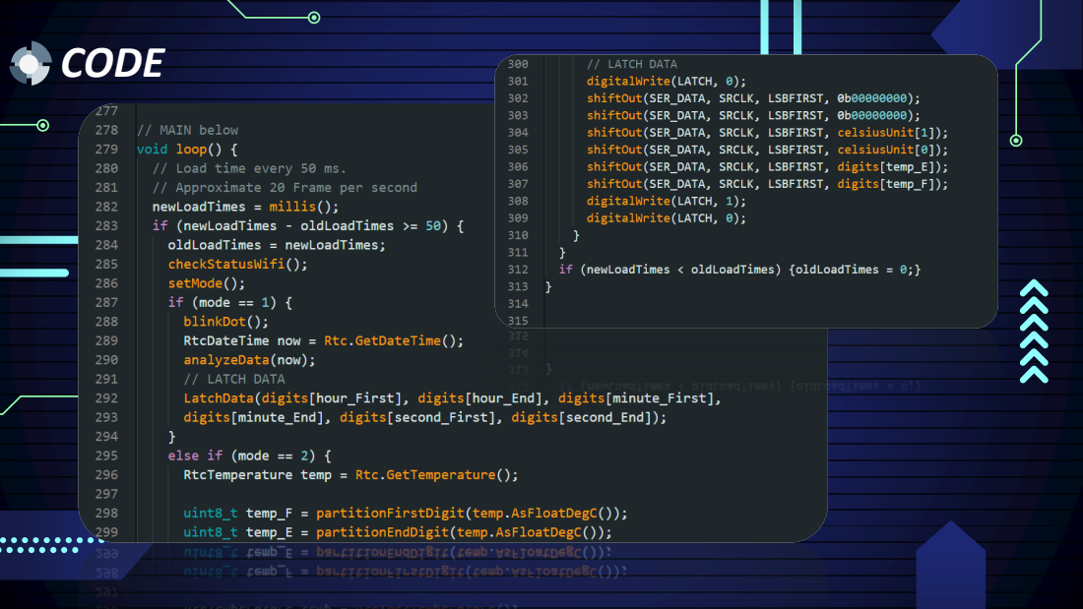
[picture p100: page 41]

# จัดท าโดย

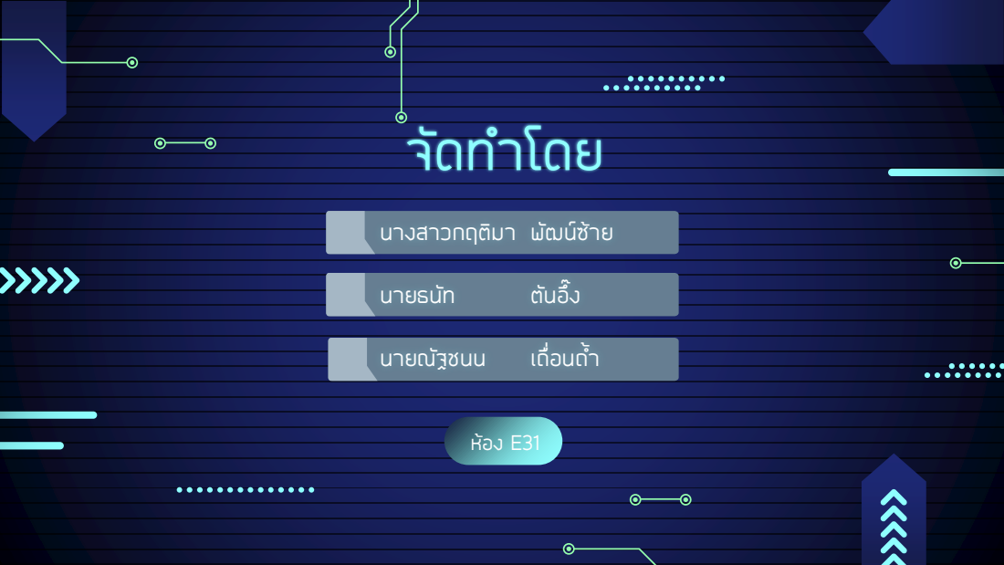
[picture p101: page 42]
นายธนัท; นายณัฐชนน; เถื่อนถ้ า

นางสาวกฤติมา พัฒน์ซ้าย
