Natchpai/proDigialClockE31/Diagrams/Schematic_RTCCLOCK_2023-02-22.pdf

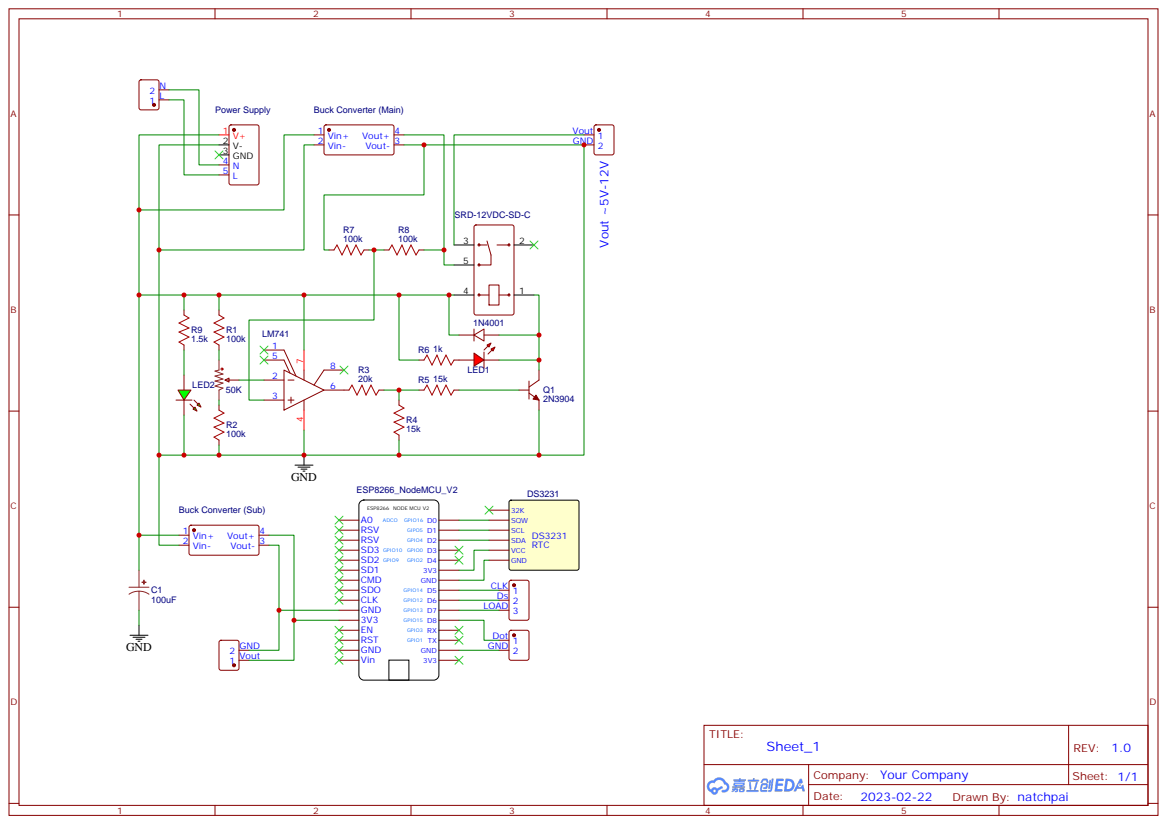
[picture p102: page 1]
