Natchpai/proDigialClockE31/Diagrams/Schematic_Segment_2023-02-22.pdf

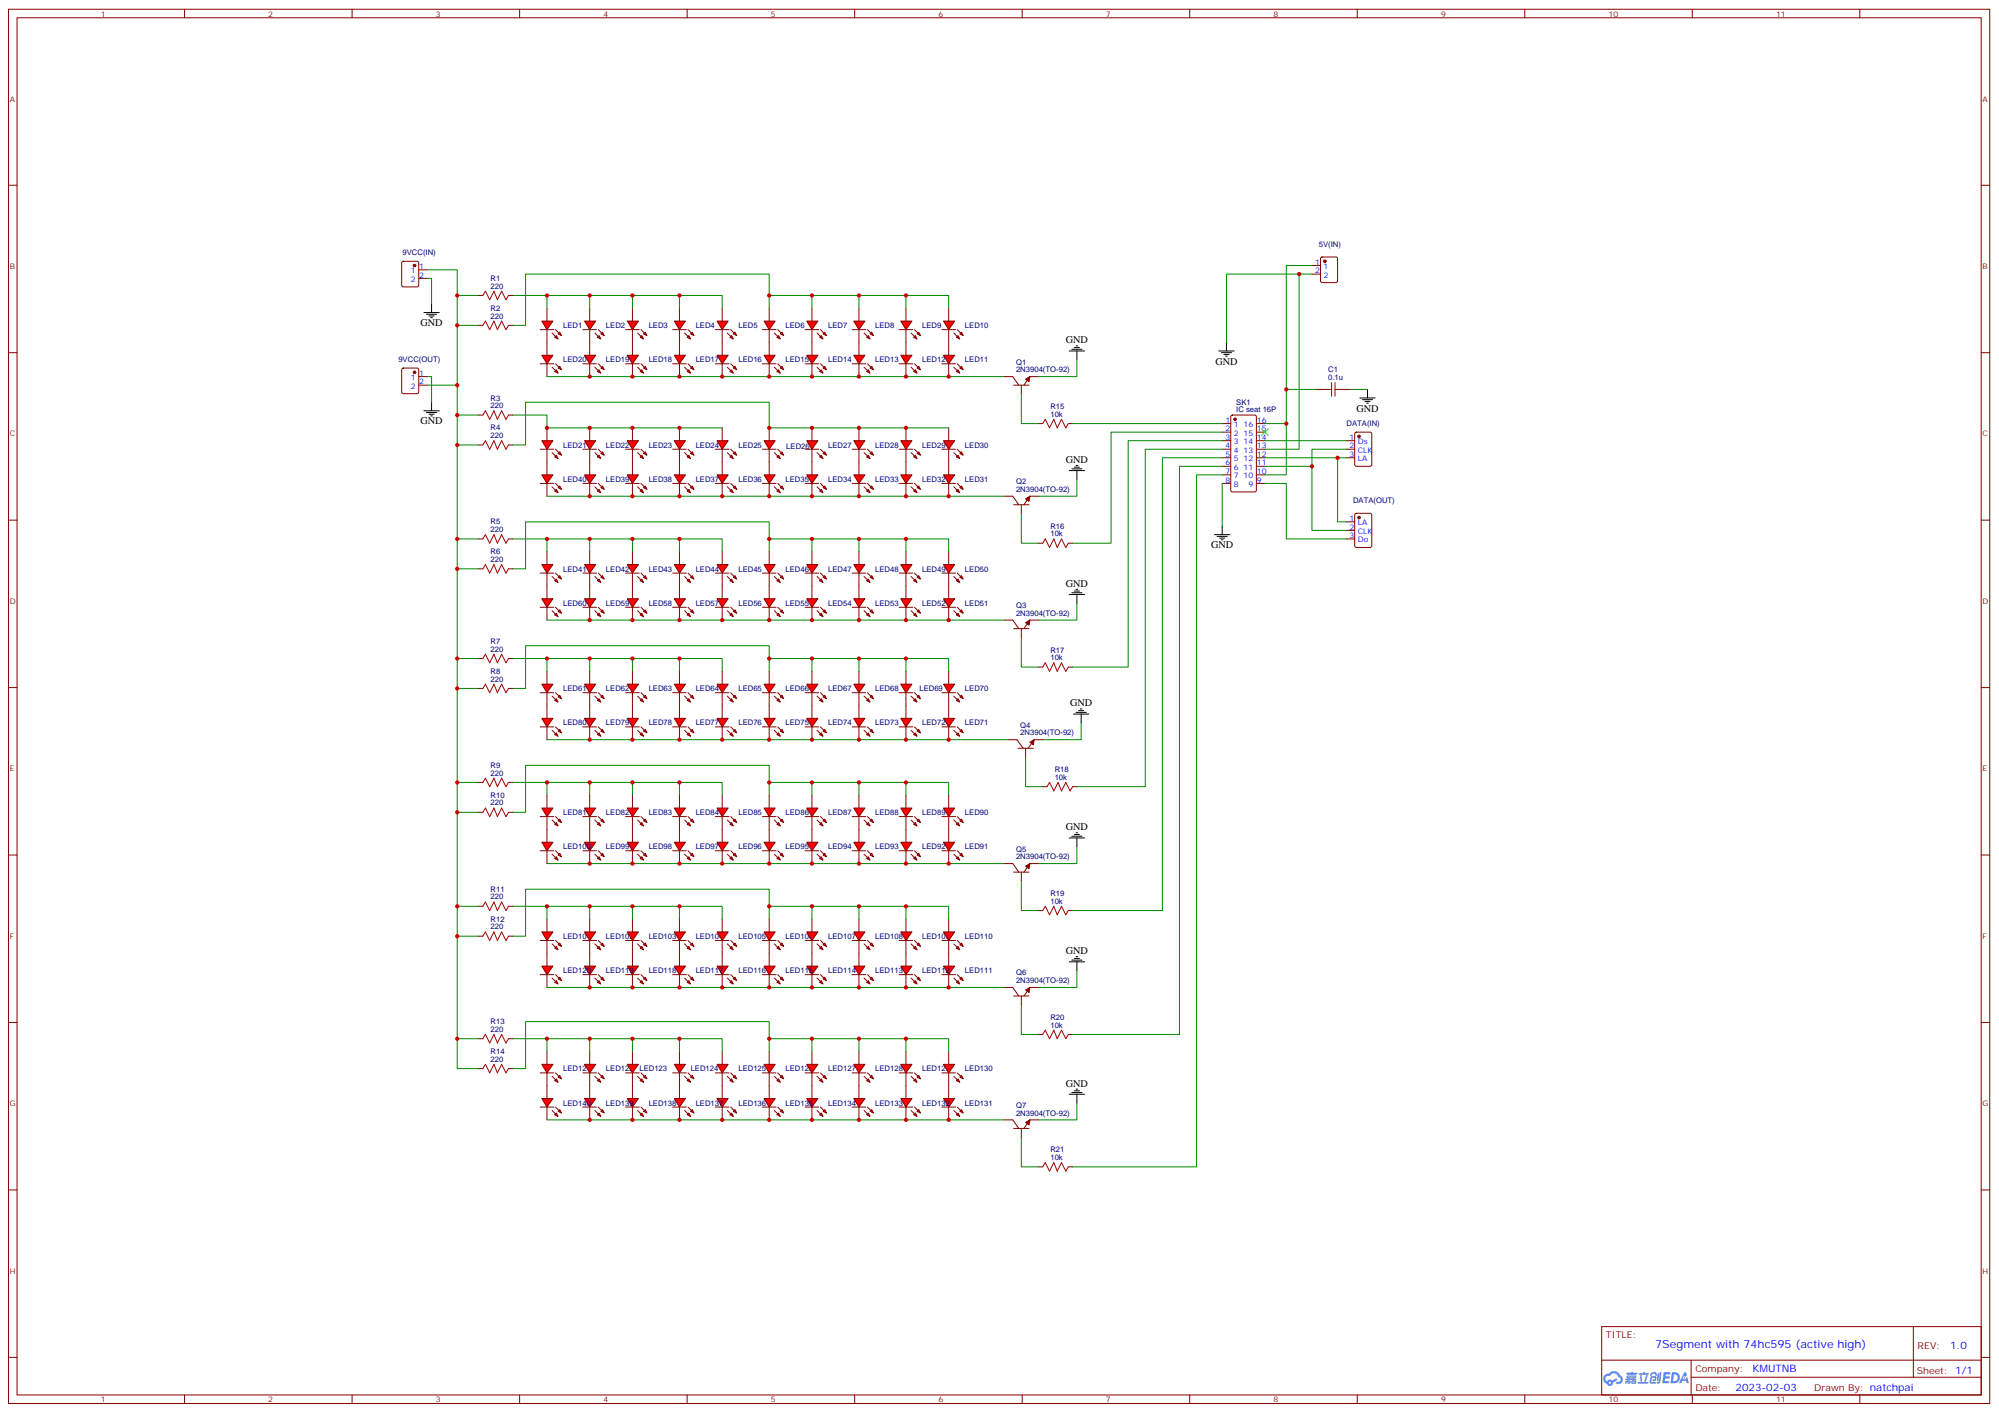
[picture p103: page 1]

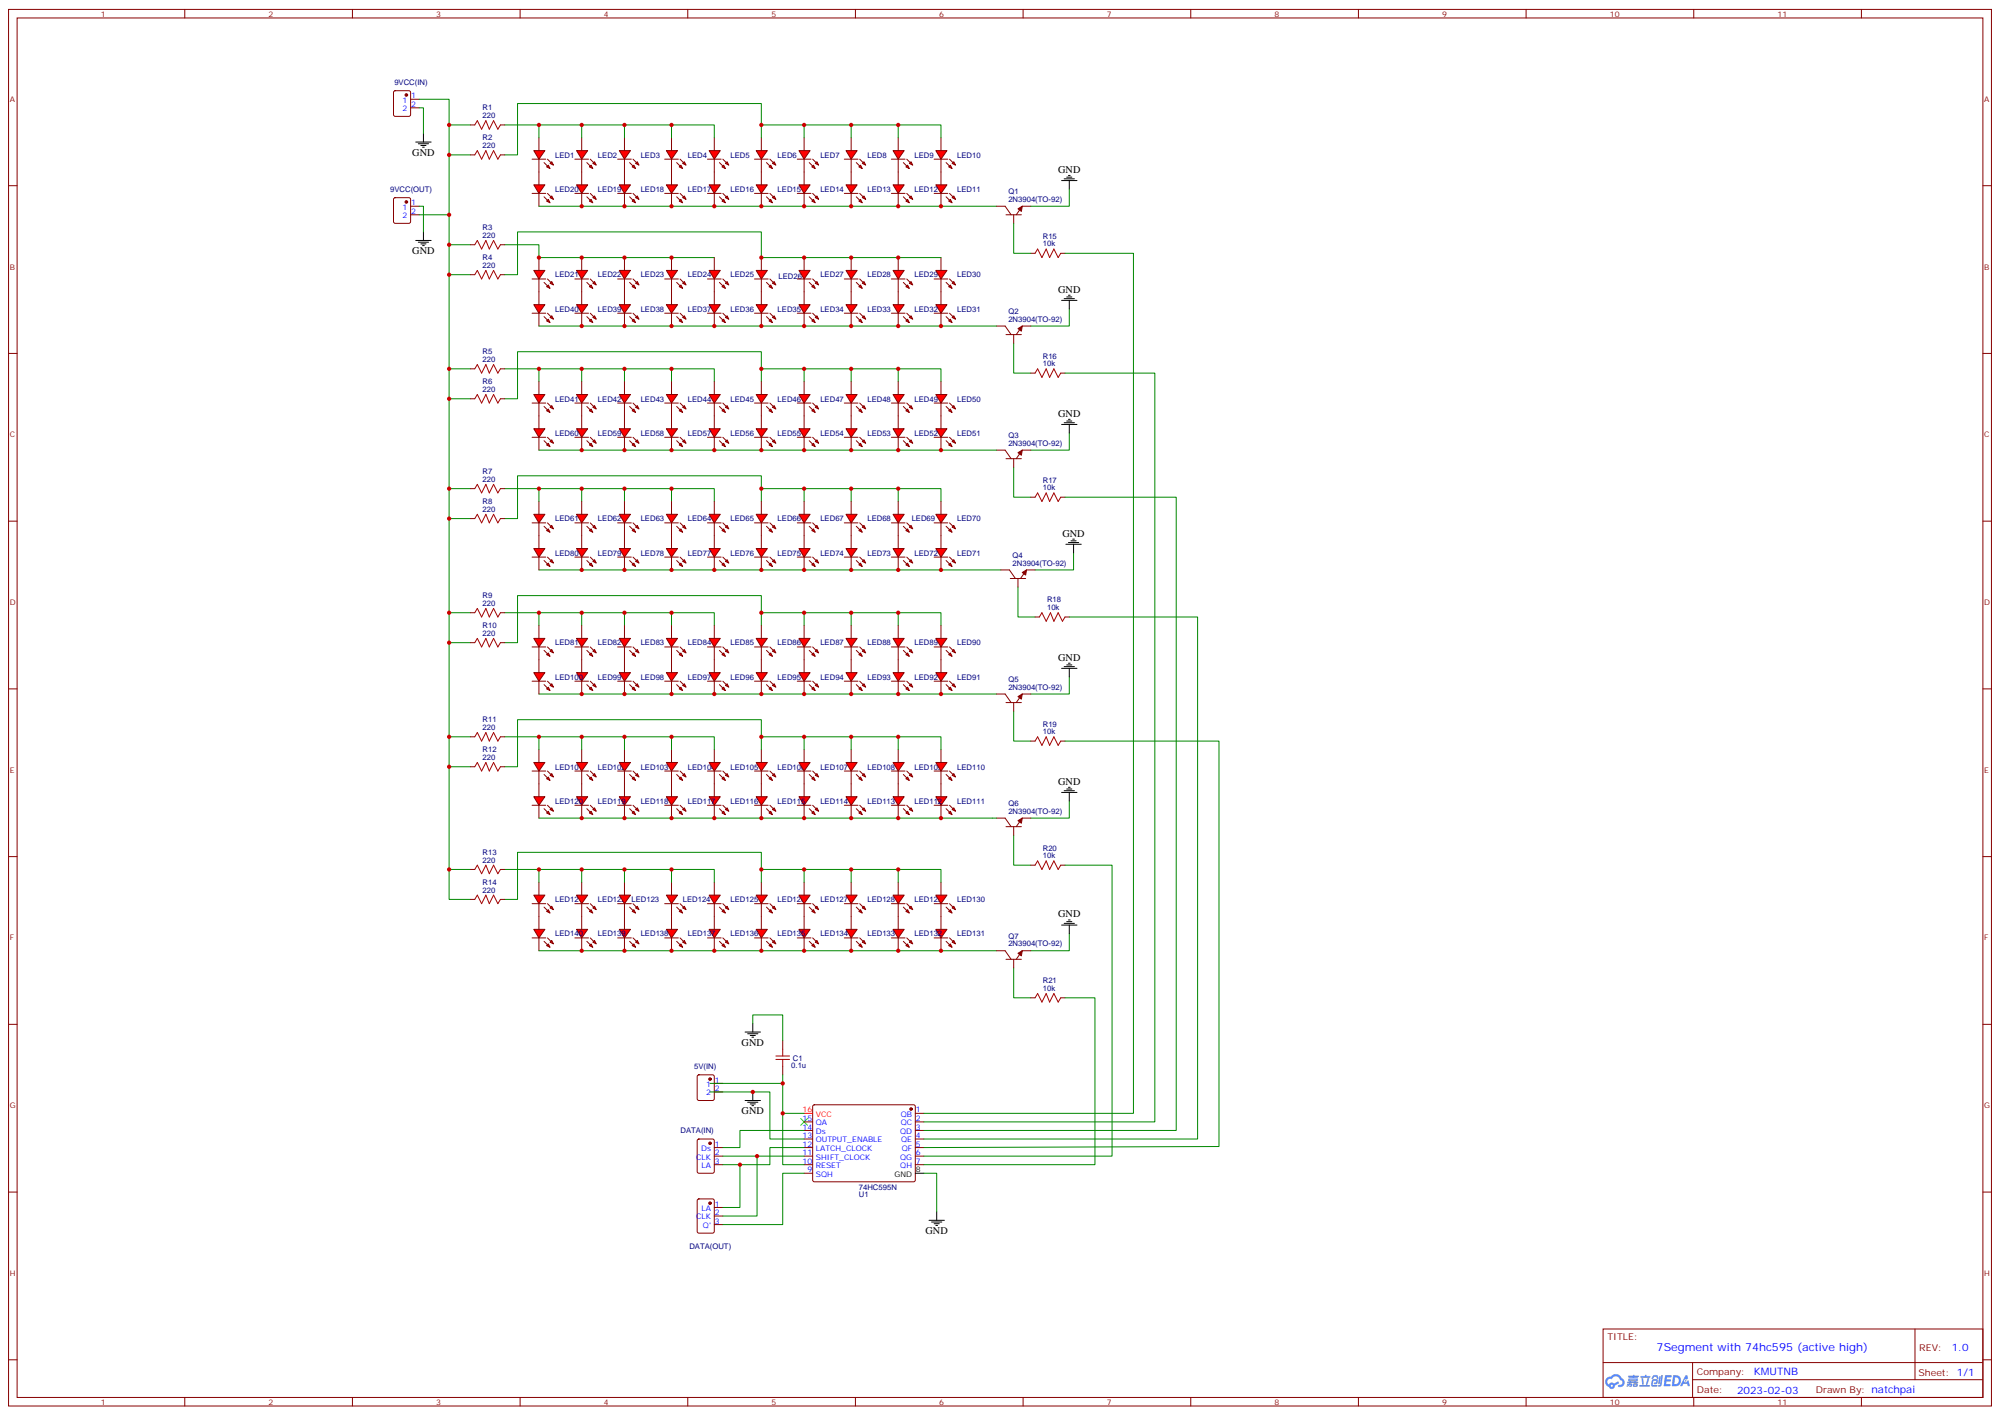
[picture p104: page 2]

RESET 10 SHIFT_CLOCK 11 LATCH_CLOCK 12 OUTPUT_ENABLE 13 Ds 14 QA 15 VCC 16
