Natchpai/proDigialClockE31/Diagrams/PCB_PCB_7Segment_BOTTOM.pdf

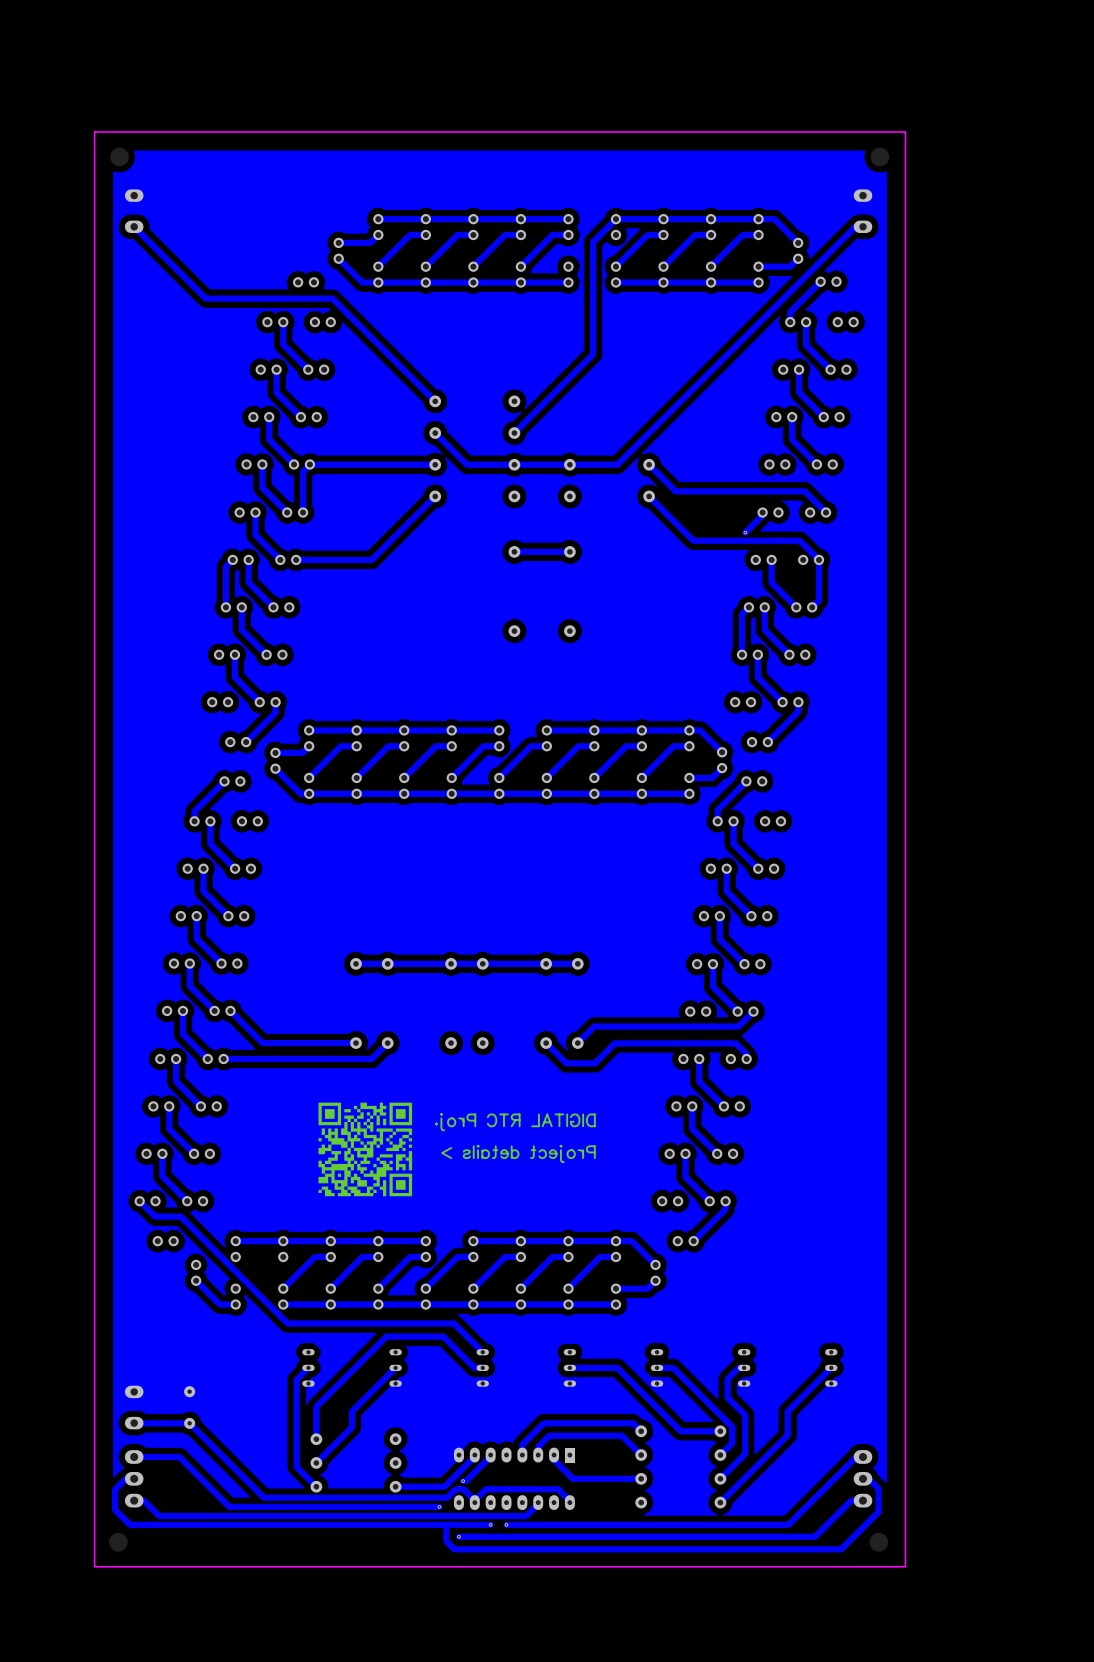
[picture p105: page 1]
