Natchpai/proDigialClockE31/Diagrams/PCB_PCB_7Segment_TOP.pdf

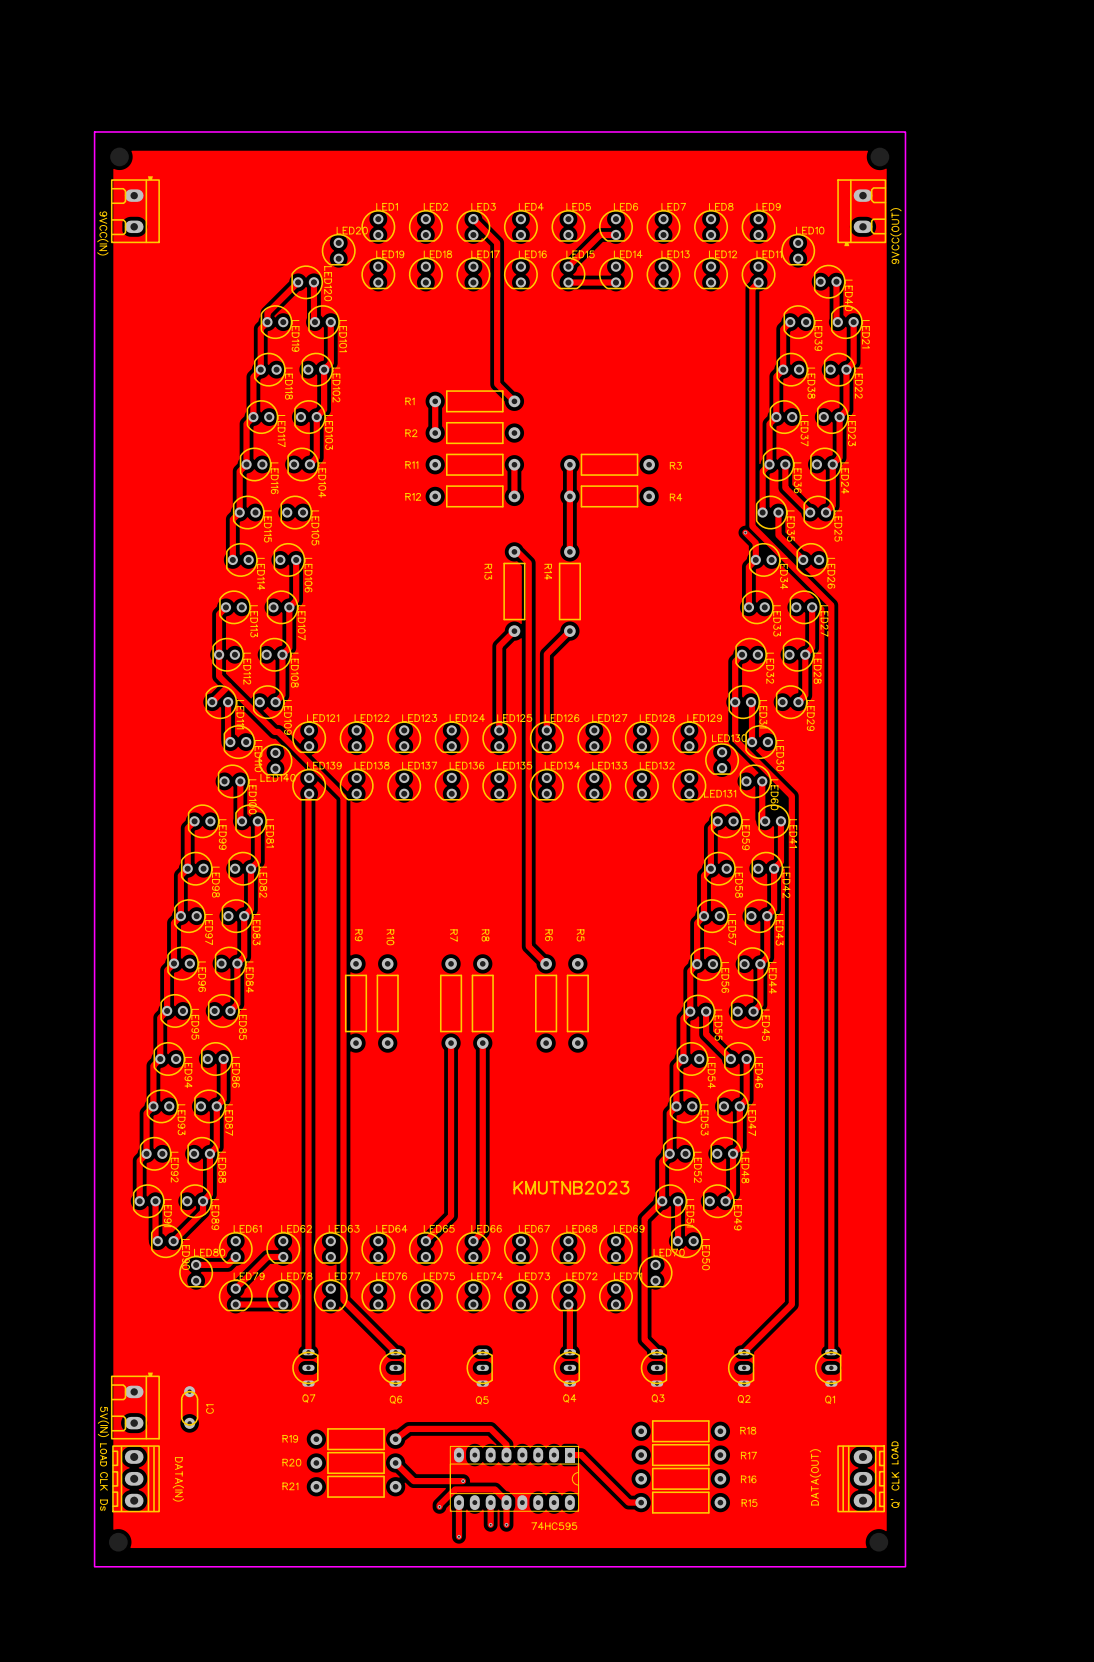
[picture p106: page 1]
