Natchpai/proDigialClockE31/(list of files, drawings)

Other design files:
boostCon.ms14
VoltProject.ms14
