Natchpai/proDigialClockE31/(commit log)

2023-02-19 Add Final code
    [VoltProject.ms14]
2023-02-26 Edit millis overflow problem
    [FINAL_CODE_ClockProject.ino]
2023-11-05 Update FINAL_CODE_ClockProject.ino
    removed "reset previousPullDataTimes" and change SSID
    [FINAL_CODE_ClockProject.ino]
2025-10-27 Changed dir.
    [VoltProject.ms14, boostCon.ms14]
